ivan-marchand/openflaps/mechanical/images/catalog/02-front.jpg

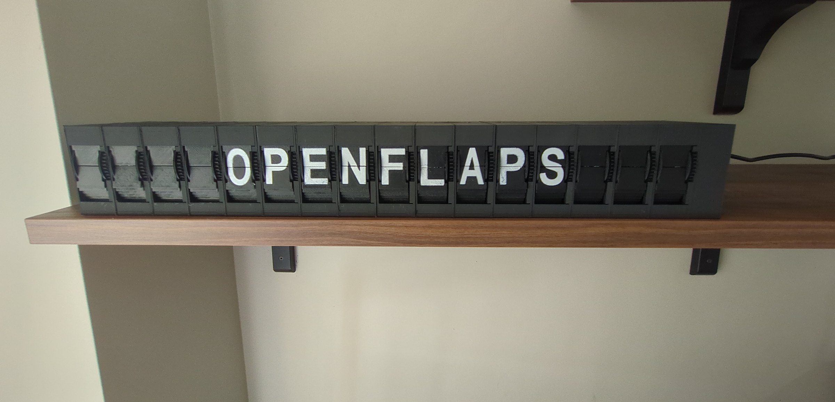
mechanical/images/catalog/02-front.jpg
