ivan-marchand/openflaps/mechanical/images/catalog/04-desk.jpg

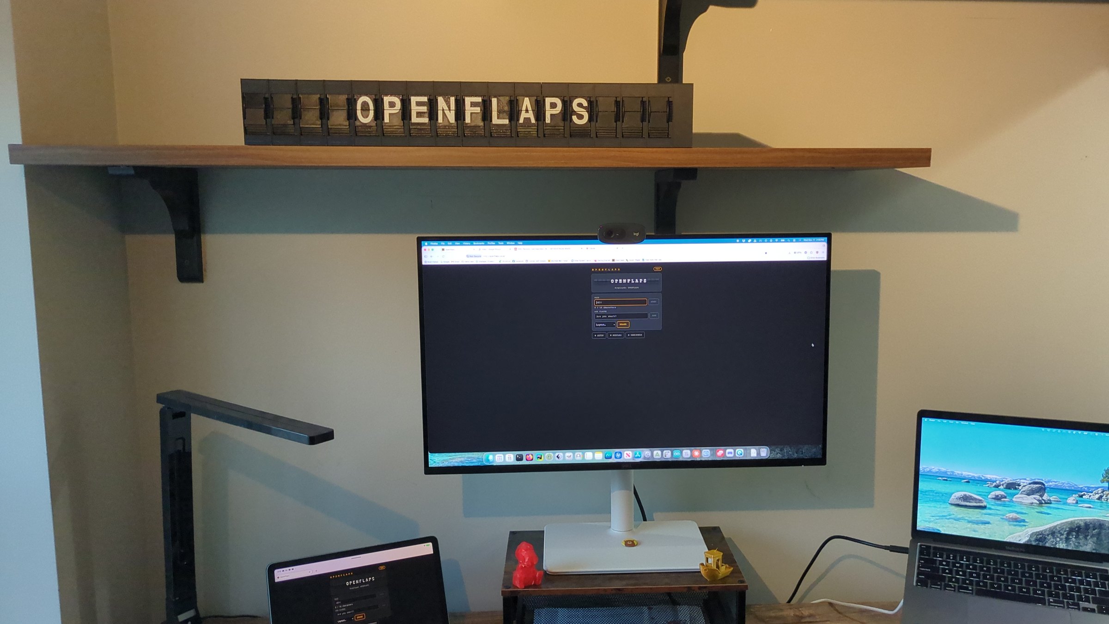
mechanical/images/catalog/04-desk.jpg
