ivan-marchand/openflaps/mechanical/images/catalog/08-layout-fields.jpg

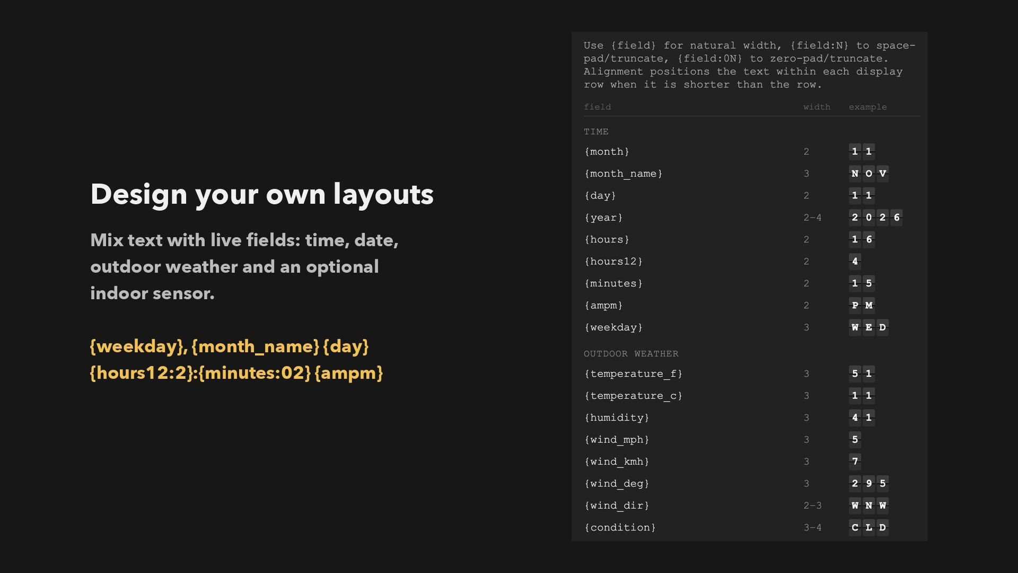
mechanical/images/catalog/08-layout-fields.jpg
