ivan-marchand/openflaps/mechanical/images/photos/03c-left-wheel-back-with-holder.jpg

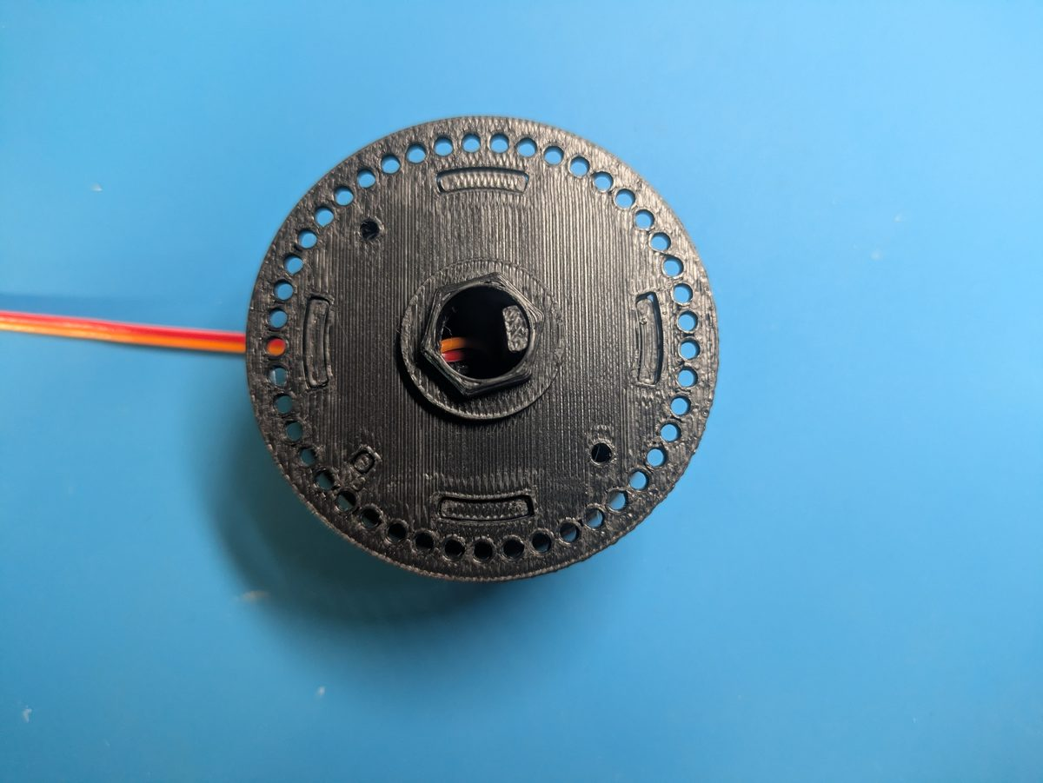
mechanical/images/photos/03c-left-wheel-back-with-holder.jpg
