ivan-marchand/openflaps/mechanical/images/photos/03d-wheels-joined-side-view.jpg

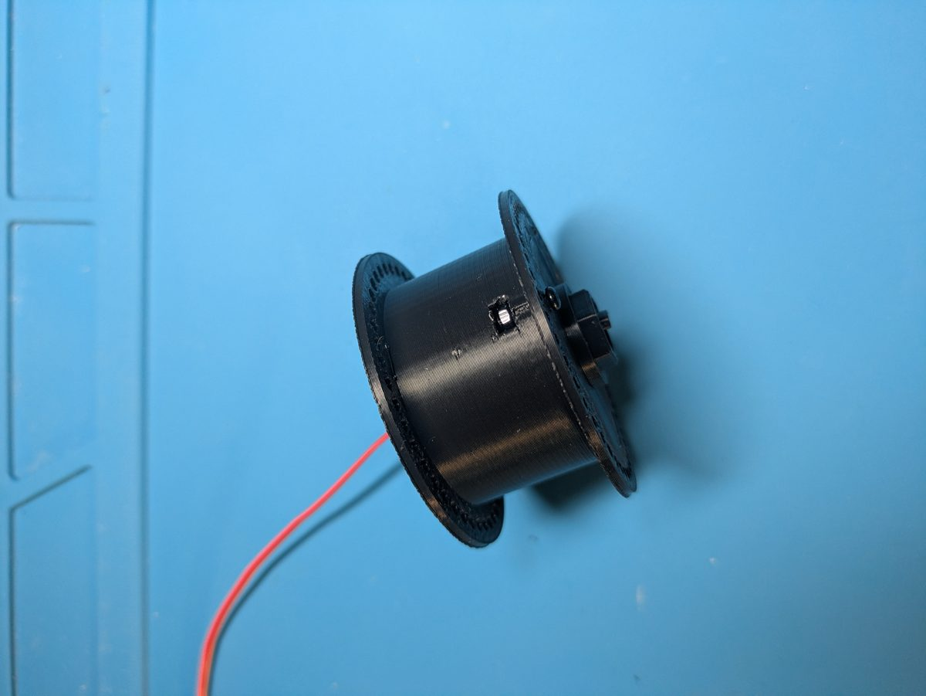
mechanical/images/photos/03d-wheels-joined-side-view.jpg
