ivan-marchand/openflaps/mechanical/images/photos/04b-first-flap-at-peg.jpg

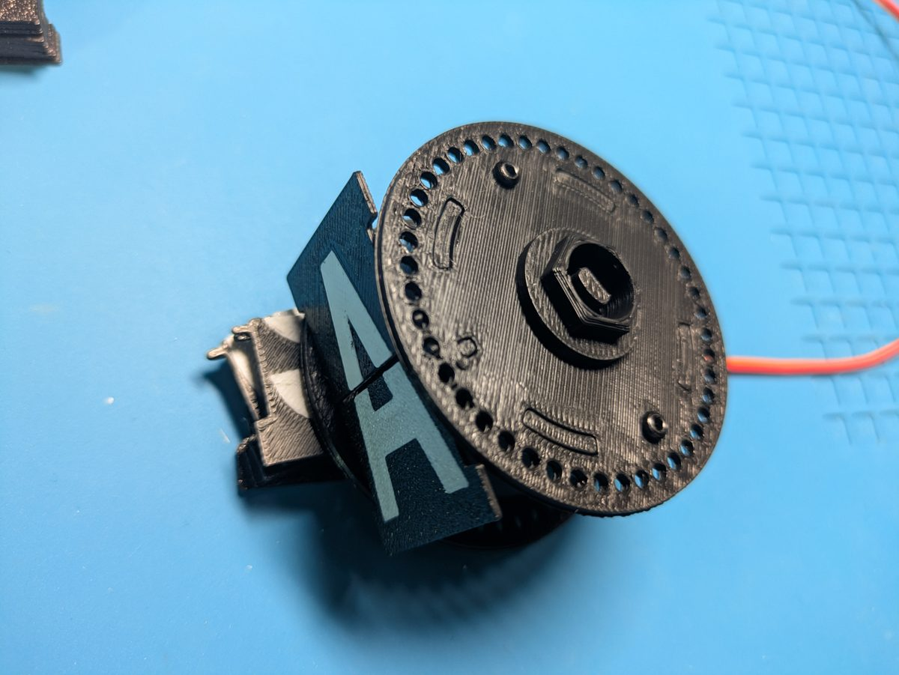
mechanical/images/photos/04b-first-flap-at-peg.jpg
