ivan-marchand/openflaps/mechanical/images/photos/04e-flaps-fully-loaded-back.jpg

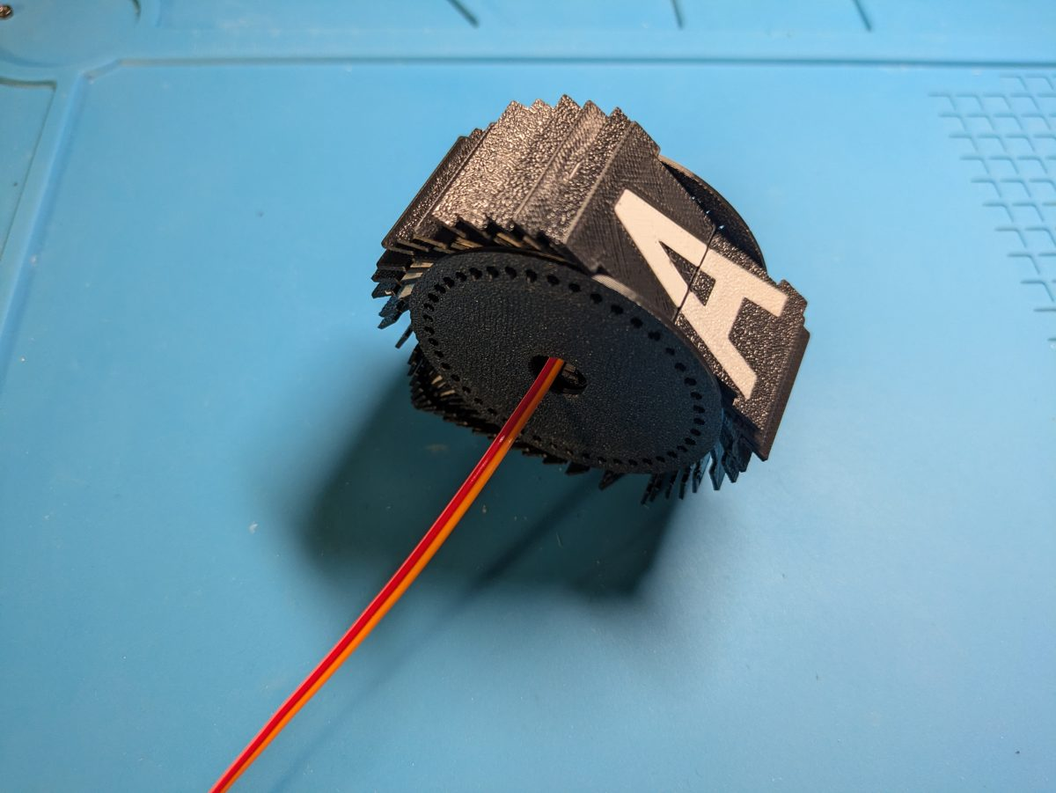
mechanical/images/photos/04e-flaps-fully-loaded-back.jpg
