ivan-marchand/openflaps/mechanical/images/photos/05c-wheel-mounted-in-frame.jpg

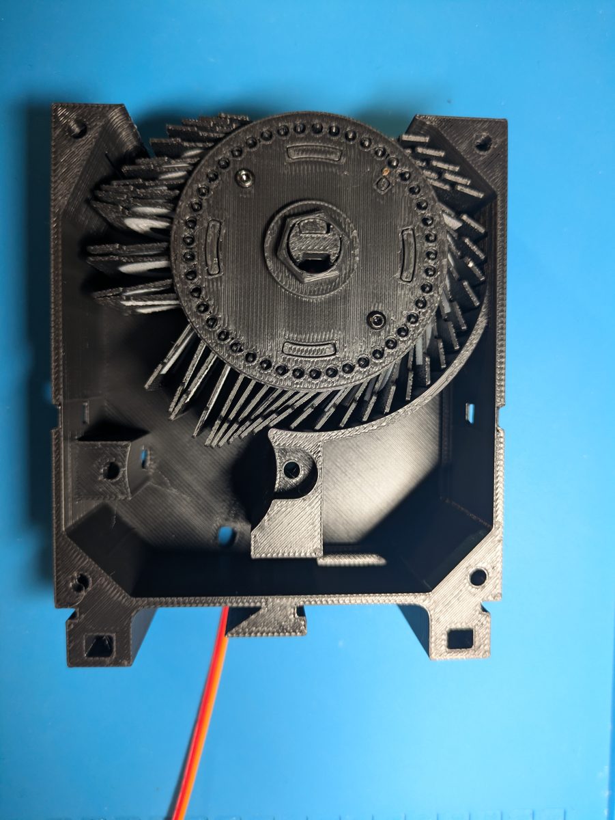
mechanical/images/photos/05c-wheel-mounted-in-frame.jpg
