ivan-marchand/openflaps/mechanical/images/photos/09b-lid-back-with-screws.jpg

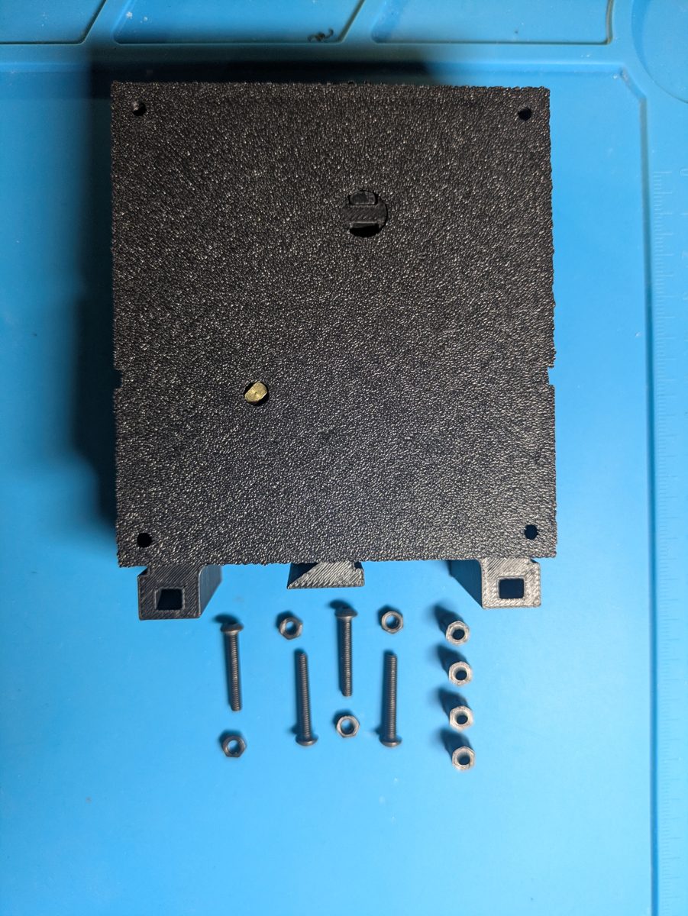
mechanical/images/photos/09b-lid-back-with-screws.jpg
