ivan-marchand/openflaps/mechanical/images/photos/09d-closed-case-angled-with-pegs.jpg

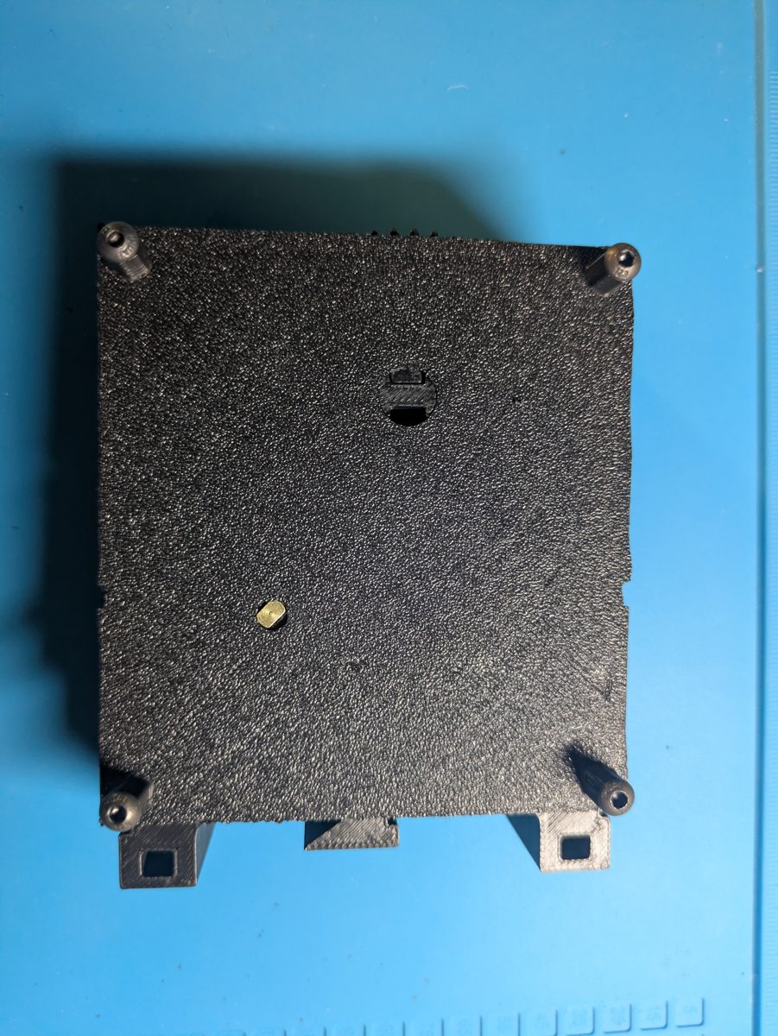
mechanical/images/photos/09d-closed-case-angled-with-pegs.jpg
