ivan-marchand/openflaps/mechanical/images/photos/09f-closed-case-back-wire-exit.jpg

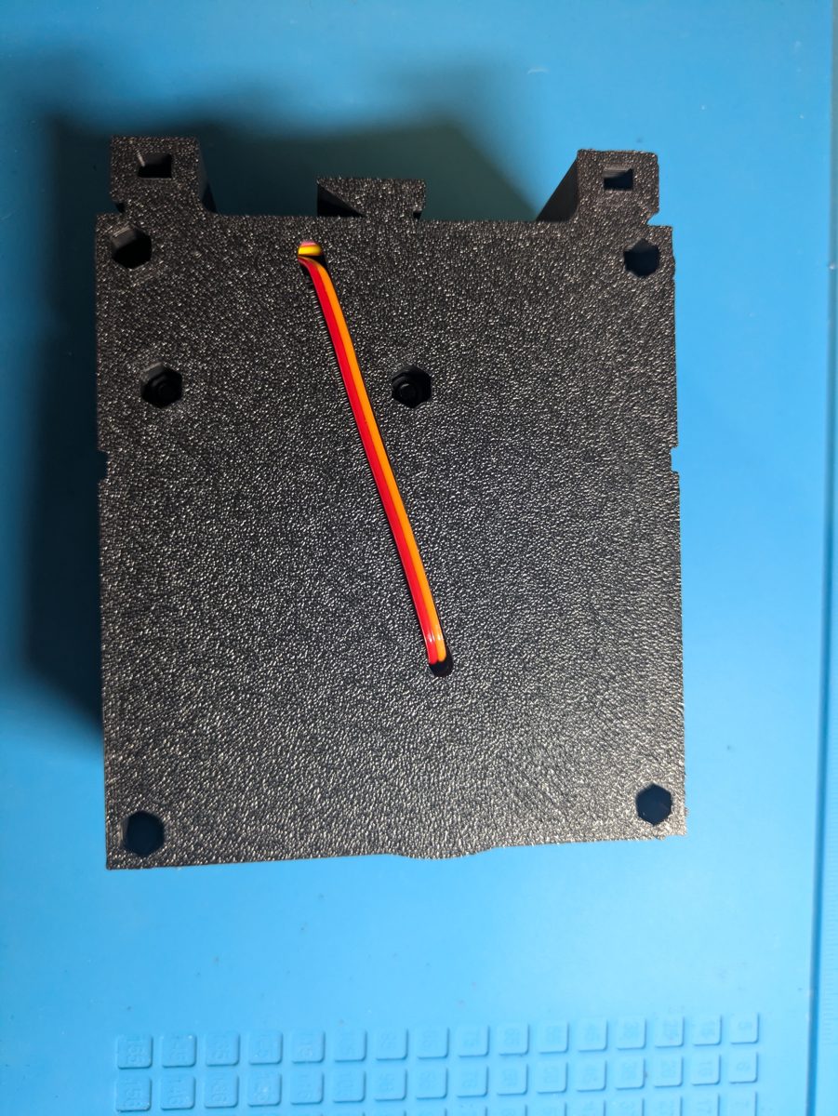
mechanical/images/photos/09f-closed-case-back-wire-exit.jpg
