ivan-marchand/openflaps/mechanical/images/photos/11d-pico-pcb-in-case-top.jpg

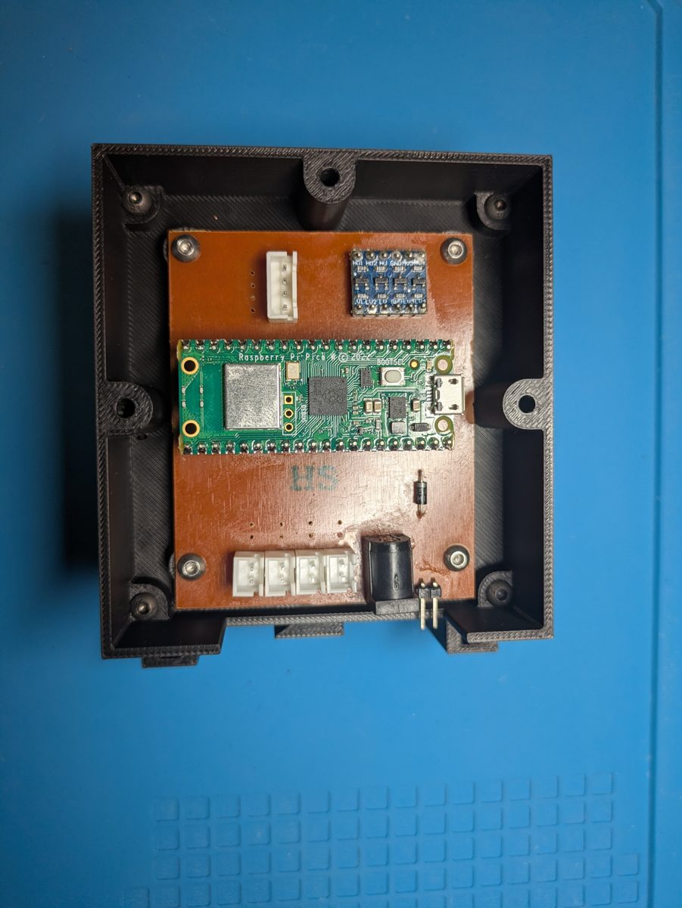
mechanical/images/photos/11d-pico-pcb-in-case-top.jpg
