ivan-marchand/openflaps/hardware/pcb/controller/BOM_PCB_Controller.csv

No. | Quantity | Comment | Designator | Footprint | Value | Manufacturer Part | Manufacturer | Supplier Part | Supplier
1 | 1 | ATTINY84A-SSF | ATTINY84 | SOIC-14_L8.7-W3.9-P1.27-LS6.0-BL |  | ATTINY84A-SSF | MICROCHIP(美国微芯) | C1340034 | LCSC
2 | 1 | 220uF | C1 | CAP-SMD_BD6.3-L6.6-W6.6-FD | 220uF | RST220UF10V018 | KNSCHA(科尼盛) | C4747973 | LCSC
3 | 1 | 100nF | C2 | CAP-SMD_L3.2-W1.6-RD | 100nF | CA45-A-35V-0.1UF-K | CEC(振华新云) | C2976900 | LCSC
4 | 1 | PZ2.54-1*2 | HOME | HDR-TH_2P-P2.54-V-M-3 |  | PZ2.54-1*2 | ZHOURI(洲日) | C5360898 | LCSC
5 | 1 | 2.54-2*3 | ICSP | HDR-TH_6P-P2.54-V-R2-C3-S2.54_A2541WV-2X3P |  | 2.54-2*3 | ZHOURI(洲日) | C5116479 | LCSC
6 | 1 | HX PZ2.54-2x2P WC-A | INPUT | HDR-TH_4P-P2.54-H-M-R2-C2-S2.54-W10.0 |  | HX PZ2.54-2x2P WC-A | hanxia(韩下) | C41417350 | LCSC
7 | 1 | 10kΩ | R1 | R0603 | 10kΩ | RC0603FR-0710KL | YAGEO(国巨) | C98220 | LCSC
8 | 1 | XH2.54-5P | STEPPER | CONN-TH_5P-P2.54_C9900008095 |  | XH2.54-5P |  | C9900017328 | LCSC
9 | 1 | GT-TCB73B-H048-L1 | SW | SW-TH_G-SWITCH_GT-TCB73B-H048-L1 |  | GT-TCB73B-H048-L1 | G-Switch(品赞) | C2890354 | LCSC
10 | 1 | ULN2003 | ULN2003 | SOP-16_L9.9-W3.9-P1.27-LS6.0-BL |  | ULN2003 | MSKSEMI(美森科) | C5252903 | LCSC
