ivan-marchand/openflaps/hardware/pcb/daisy-chain/BOM_PCB_Daisy_Chain.csv

No. | Quantity | Comment | Designator | Footprint | Value | Manufacturer Part | Manufacturer | Supplier Part | Supplier
1 | 1 | JXT-XH2.54-2PWZ | 5V | CONN-TH_2P-P2.54_JXT-XH2.54-2PWZ |  | JXT-XH2.54-2PWZ | JXTCONN(聚兴泰) | C53207536 | LCSC
2 | 4 | HX PM2.54-2x2P ZC | D1,D2,D3,D4 | CONN-TH_HX-PM2.54-2X2P-ZC |  | HX PM2.54-2x2P ZC | hanxia(韩下) | C32713303 | LCSC
3 | 1 | HX PM2.54-1x2P WC-Y | I2CIN | HDR-TH_2P-P2.54-H-F-W10.2-N |  | HX PM2.54-1x2P WC-Y | hanxia(韩下) | C22438143 | LCSC
4 | 1 | PZ254-1-02-W-8.5 | U1 | HDR-TH_2P-P2.54-H-M-W10.4 |  | PZ254-1-02-W-8.5 | HCTL(华灿天禄) | C3012223 | LCSC
