ivan-marchand/openflaps/hardware/pcb/pico-controller/BOM_PCB_Pico_Controller.csv

No. | Quantity | Comment | Designator | Footprint | Value | Manufacturer Part | Manufacturer | Supplier Part | Supplier
1 | 1 | DC-005-A25 | 5V-IN | DC-IN-TH_DC-005-A20 |  | DC-005-A25 | Yuandi(元迪) | C19077753 | LCSC
2 | 8 | A2502-WV02 | 5V-OUT1,5V-OUT2,5V-OUT3,5V-OUT4,5V-OUT5,5V-OUT6,5V-OUT7,5V-OUT8 | CONN-TH_A2502-WV02 |  | A2502-WV02 |  | C9900002556 | LCSC
3 | 2 | SH-XH2.54-4PZZ | ACCI2C1,ACCI2C2 | CONN-TH_4P-P2.50_BX-XH2.54-4PZZ |  | SH-XH2.54-4PZZ | SHOU HAN(首韩) | C54431935 | LCSC
4 | 1 | 1N5819 | D1 | DO-41_BD2.4-L4.7-P8.70-D0.8-RD |  | 1N5819 | luJing(鲁晶) | C49318088 | LCSC
5 | 1 | PZ254-1-02-W-8.5 | I2C | HDR-TH_2P-P2.54-H-M-W10.4 |  | PZ254-1-02-W-8.5 | HCTL(华灿天禄) | C3012223 | LCSC
6 | 1 | IIC I2C Logic Level Converter | I2CConverter | DPI-12 10.5W
7 | 2 | 254PM-1x20P-V | PICO1,PICO2 | HDR-TH_20P-P2.54-V-F-2 |  | 254PM-1x20P-V | LXWCONN(连兴旺电子) | C53202183 | LCSC
