ivan-marchand/openflaps/mechanical/images/photos/04a-flap-parts.jpg

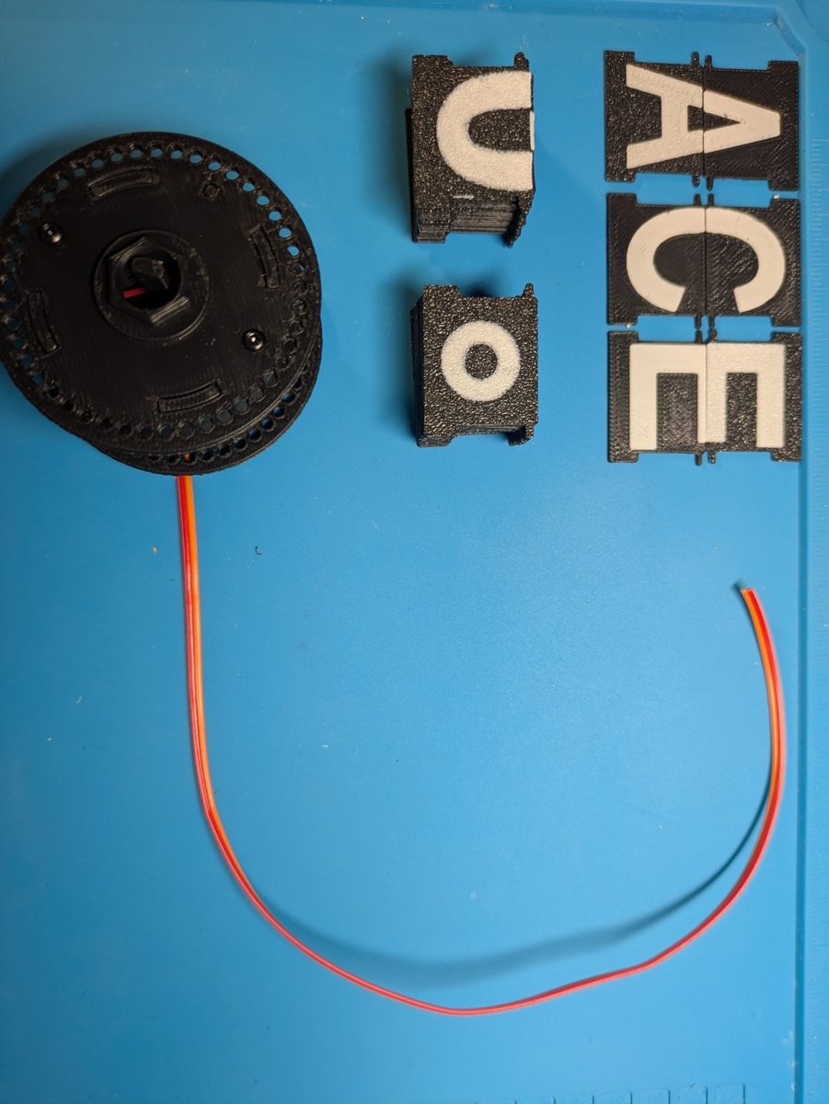
mechanical/images/photos/04a-flap-parts.jpg
