ivan-marchand/openflaps/mechanical/images/photos/05a-frame-and-wheel-parts.jpg

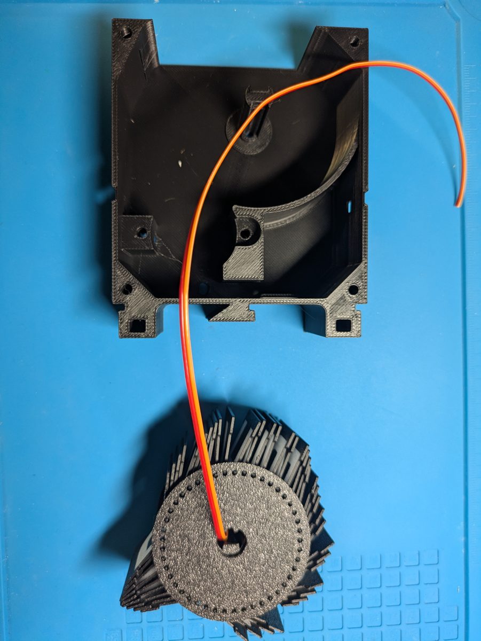
mechanical/images/photos/05a-frame-and-wheel-parts.jpg
