ivan-marchand/openflaps/mechanical/images/photos/07a-gear-parts.jpg

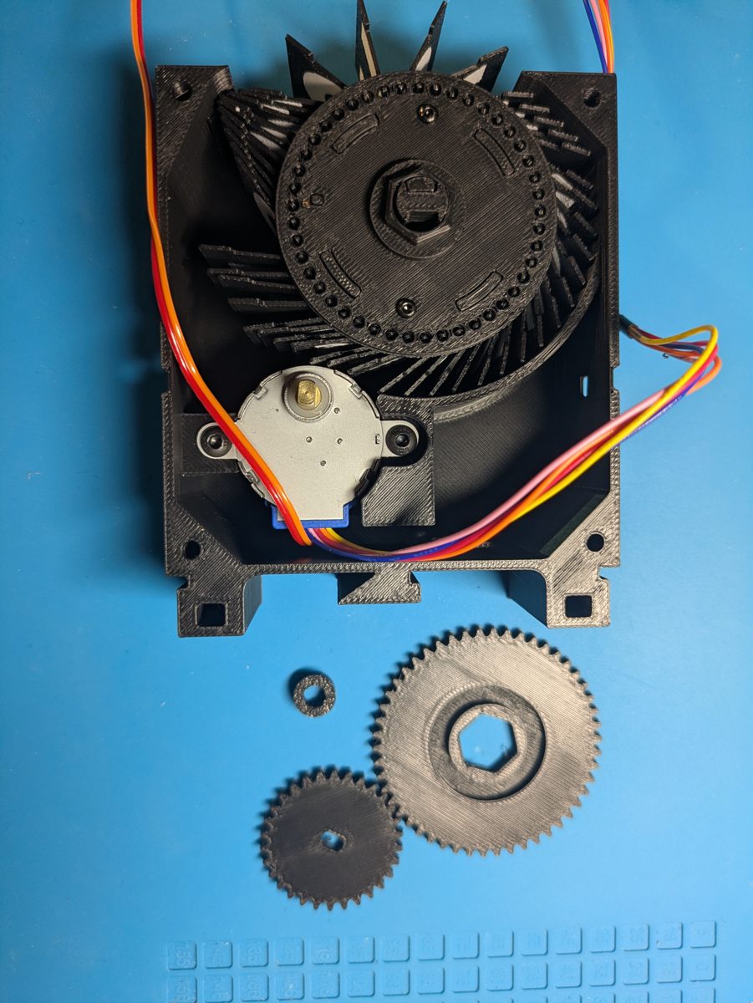
mechanical/images/photos/07a-gear-parts.jpg
