ivan-marchand/openflaps/mechanical/images/photos/08a-pcb-header-parts.jpg

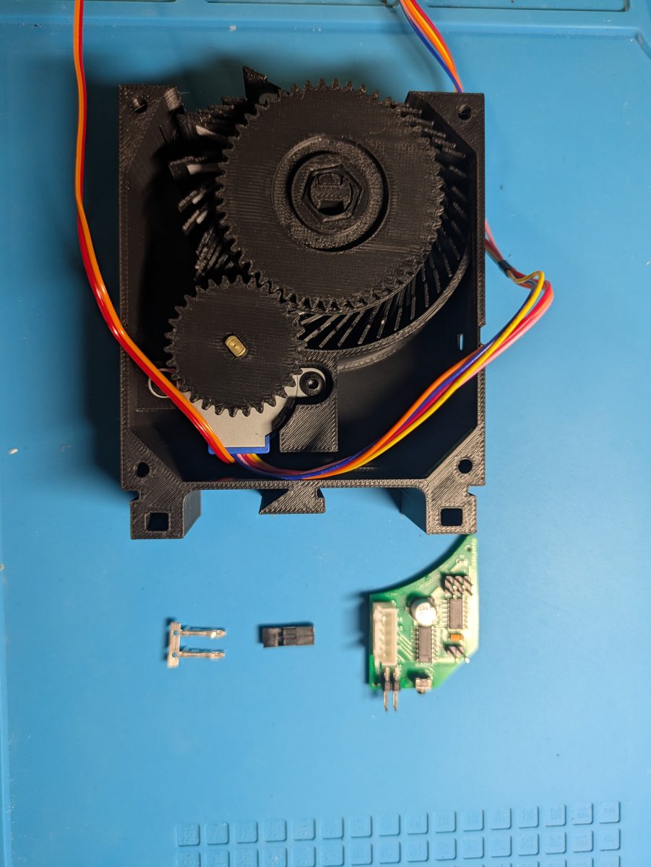
mechanical/images/photos/08a-pcb-header-parts.jpg
