ivan-marchand/openflaps/mechanical/images/photos/08b-pcb-header-parts-angle2.jpg

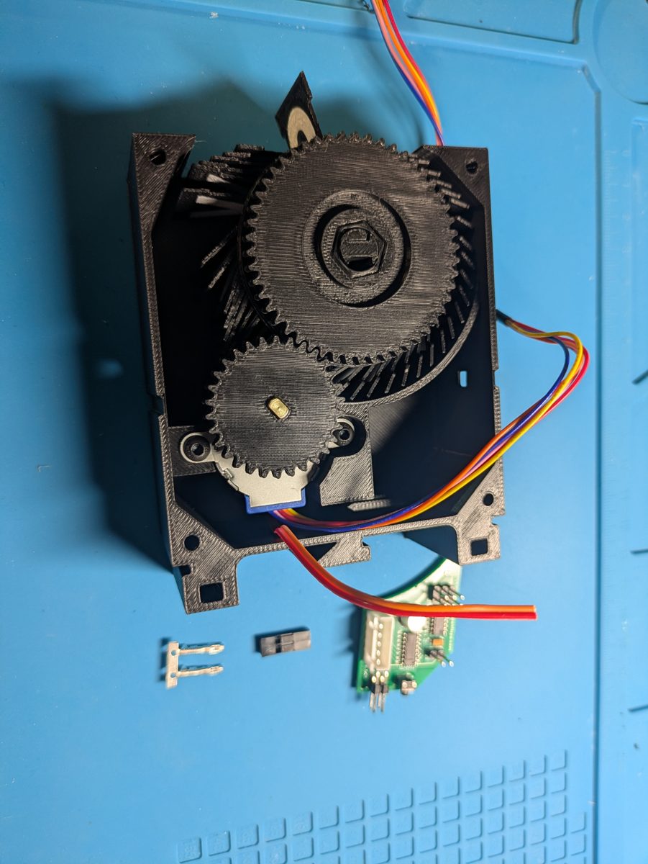
mechanical/images/photos/08b-pcb-header-parts-angle2.jpg
