ivan-marchand/openflaps/mechanical/stl/flaps/flap_13_5_6.3mf

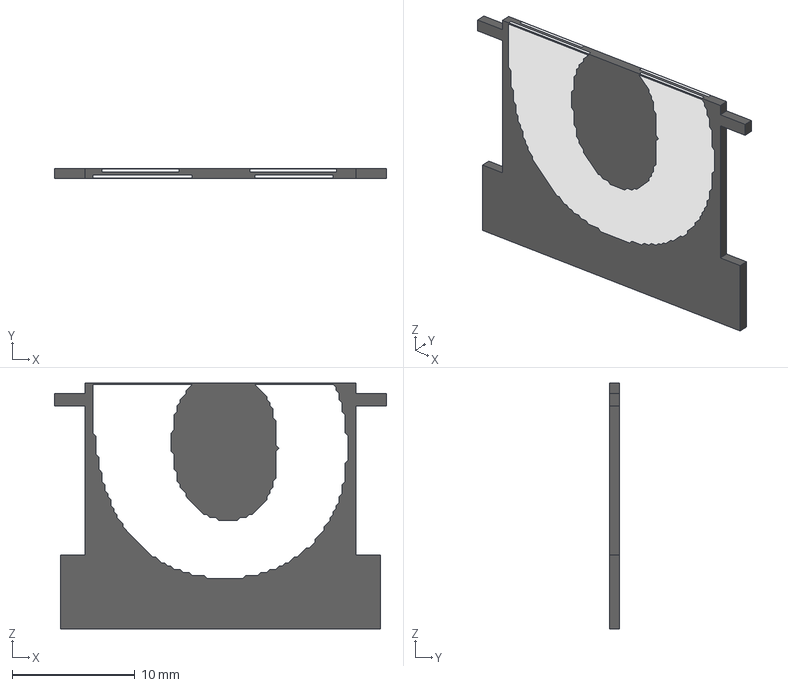
[picture p24: CAD file, 2026-11-07]
mechanical/stl/flaps/flap_13_5_6.3mf
27.0 x 0.802 x 20.0 mm
flap
5_top_front
6_bottom_back
