ivan-marchand/openflaps/mechanical/stl/Split Flap Character - Front Connector Peg.stl

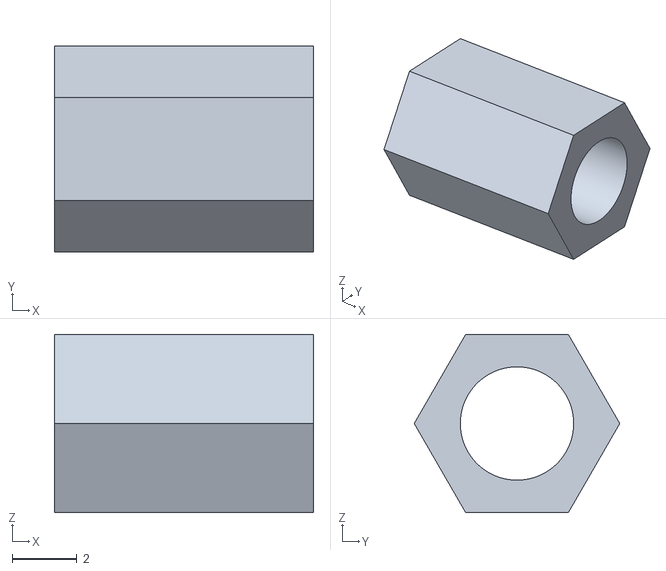
[picture p25: CAD file, 2026-11-07]
mechanical/stl/Split Flap Character - Front Connector Peg.stl
8.00 x 6.35 x 5.50
