ivan-marchand/openflaps/mechanical/stl/flaps/flap_34_K_L.3mf

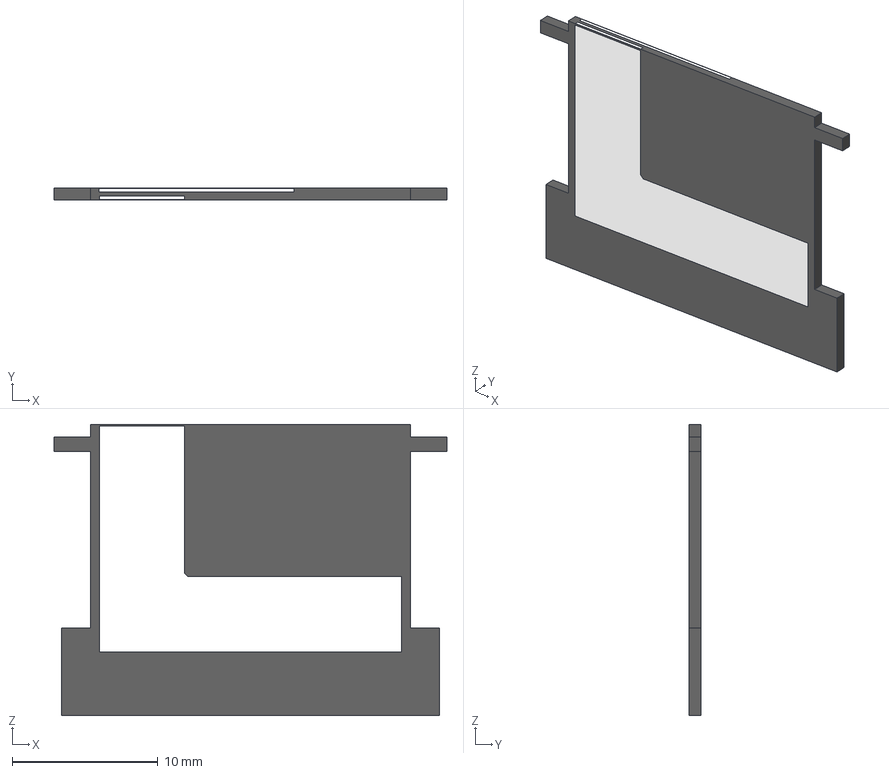
[picture p26: CAD file, 2026-11-07]
mechanical/stl/flaps/flap_34_K_L.3mf
27.0 x 0.802 x 20.0 mm
flap
K_top_front
L_bottom_back
