ivan-marchand/openflaps/mechanical/stl/Split Flap Character - Pico Case Lid.stl

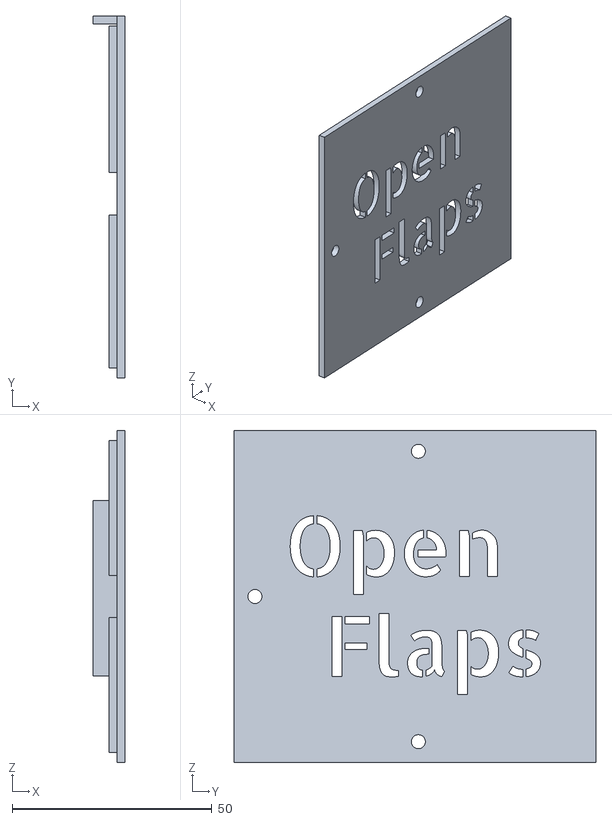
[picture p27: CAD file, 2026-11-07]
mechanical/stl/Split Flap Character - Pico Case Lid.stl
8.00 x 90.6 x 83.1
