ivan-marchand/openflaps/mechanical/stl/flaps/flap_18_0_1.3mf

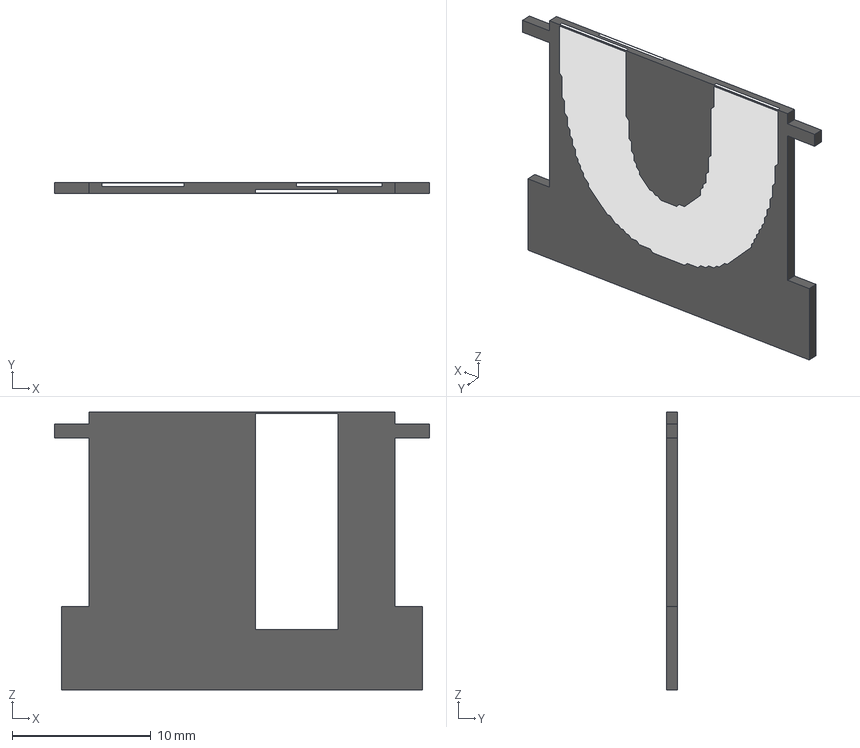
[picture p28: CAD file, 2026-11-07]
mechanical/stl/flaps/flap_18_0_1.3mf
27.0 x 0.802 x 20.0 mm
flap
0_top_front
1_bottom_back
