ivan-marchand/openflaps/mechanical/stl/Split Flap Character - Pico Case.stl

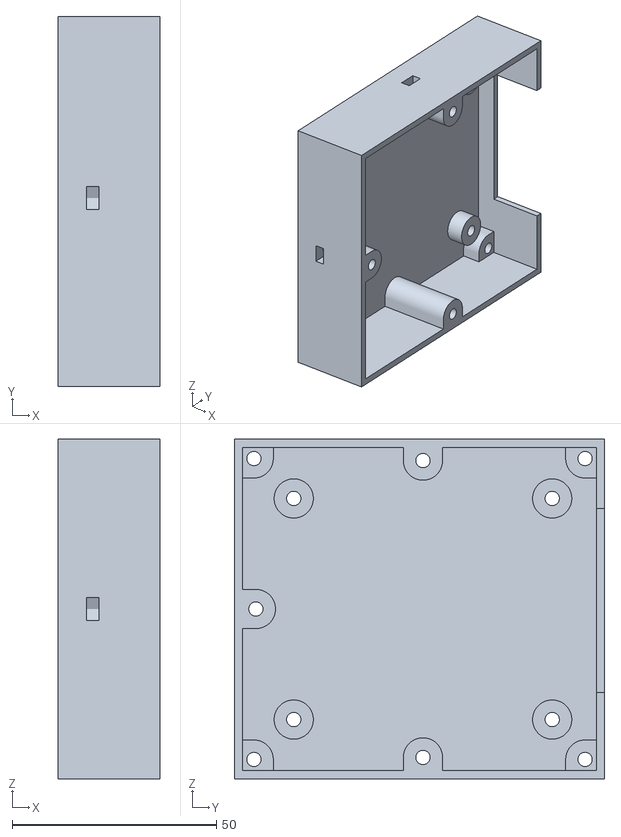
[picture p29: CAD file, 2026-11-07]
mechanical/stl/Split Flap Character - Pico Case.stl
25.0 x 90.6 x 83.1
