ivan-marchand/openflaps/mechanical/stl/flaps/flap_35_J_K.3mf

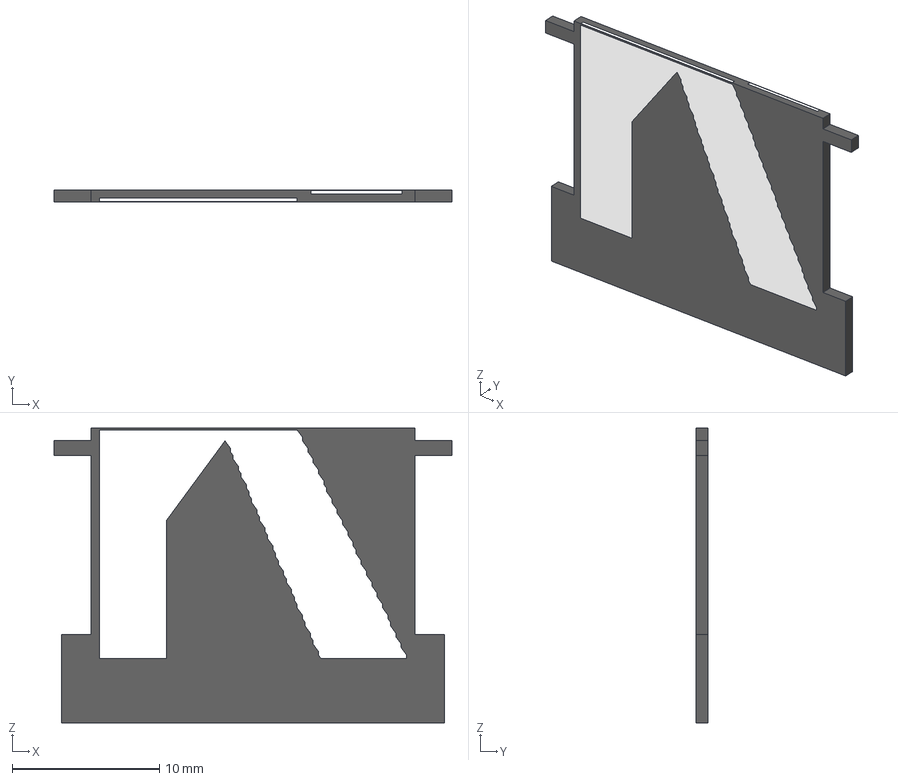
[picture p30: CAD file, 2026-11-07]
mechanical/stl/flaps/flap_35_J_K.3mf
27.0 x 0.802 x 20.0 mm
flap
J_top_front
K_bottom_back
