ivan-marchand/openflaps/mechanical/stl/Split Flap Character - Character Attachment Clip.stl

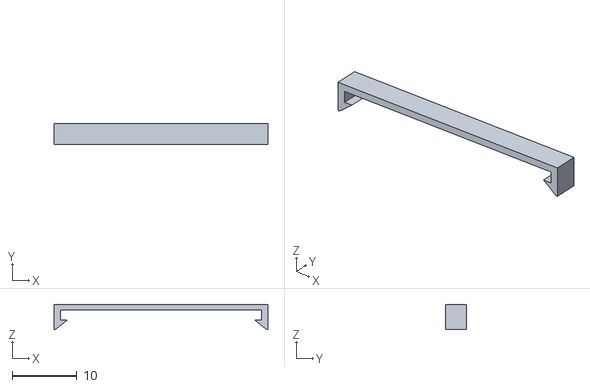
[picture p31: CAD file, 2026-11-07]
mechanical/stl/Split Flap Character - Character Attachment Clip.stl
33.1 x 3.20 x 3.90
