ivan-marchand/openflaps/mechanical/stl/Split Flap Character - Frame.stl

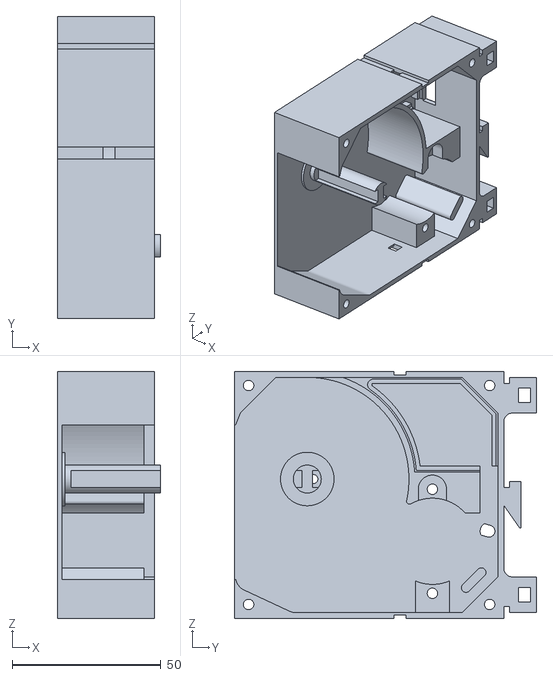
[picture p32: CAD file, 2026-11-07]
mechanical/stl/Split Flap Character - Frame.stl
34.5 x 101.6 x 83.1
