ivan-marchand/openflaps/mechanical/stl/Split Flap Character - Lid.stl

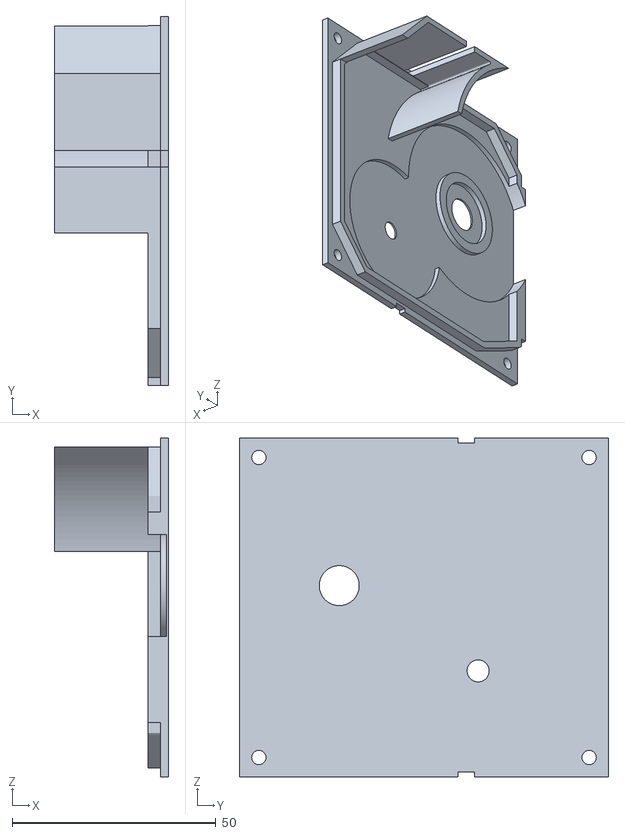
[picture p33: CAD file, 2026-11-07]
mechanical/stl/Split Flap Character - Lid.stl
28.0 x 90.6 x 83.1
