ivan-marchand/openflaps/mechanical/stl/Split Flap Character - Stepper Motor Gear Spacer.stl

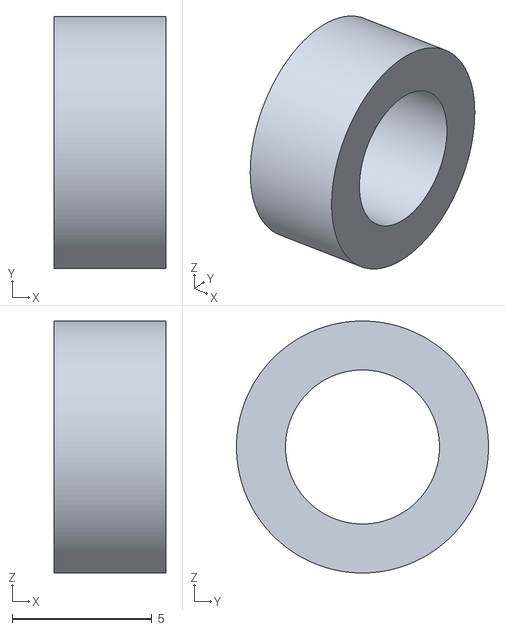
[picture p34: CAD file, 2026-03-02]
mechanical/stl/Split Flap Character - Stepper Motor Gear Spacer.stl
4.00 x 9.00 x 9.00
