ivan-marchand/openflaps/mechanical/stl/Gear 50x30 - Wheel 50.stl

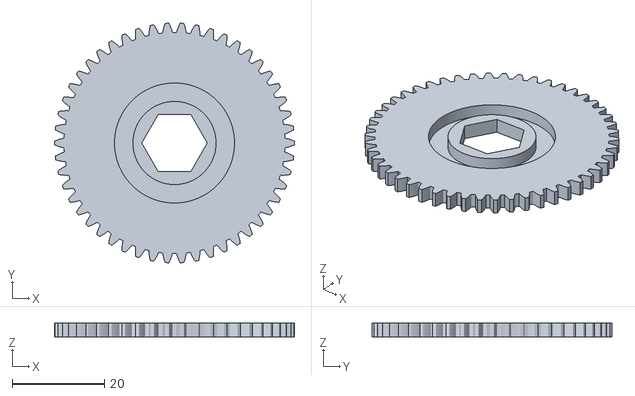
[picture p35: CAD file, 2026-03-02]
mechanical/stl/Gear 50x30 - Wheel 50.stl
52.0 x 51.9 x 3.00
