ivan-marchand/openflaps/mechanical/stl/Split Flap Character - Left Wheel.stl

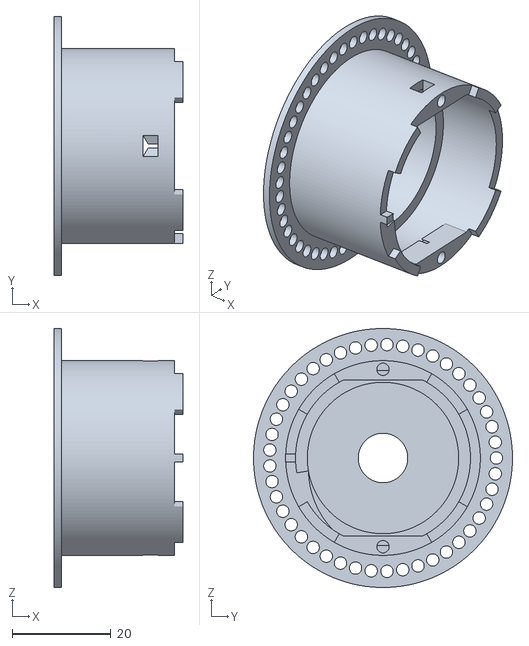
[picture p36: CAD file, 2026-03-02]
mechanical/stl/Split Flap Character - Left Wheel.stl
26.0 x 52.4 x 52.4
