ivan-marchand/openflaps/mechanical/stl/Split Flap Character - Flap.stl

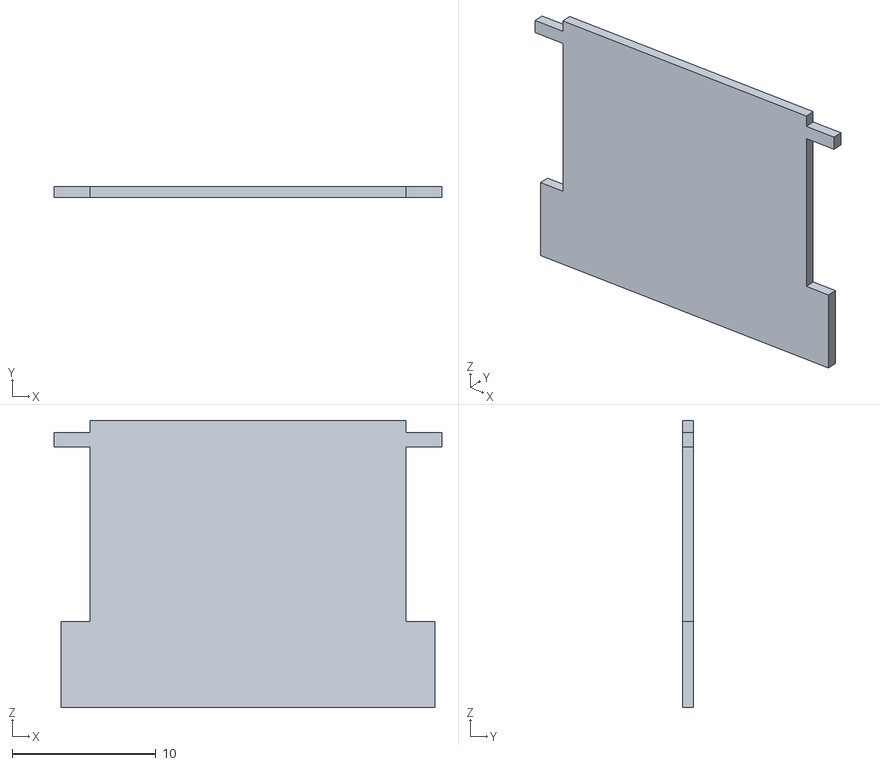
[picture p37: CAD file, 2026-03-02]
mechanical/stl/Split Flap Character - Flap.stl
27.0 x 0.8 x 20.0
