ivan-marchand/openflaps/mechanical/stl/Split Flap Character - Limit Switch Support.stl

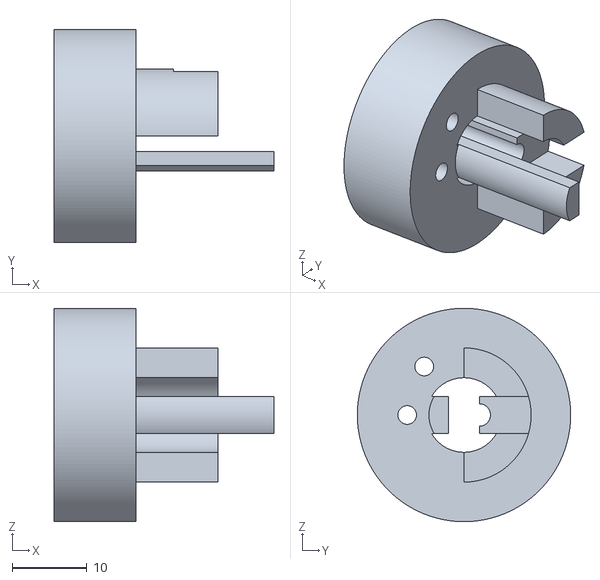
[picture p38: CAD file, 2026-03-02]
mechanical/stl/Split Flap Character - Limit Switch Support.stl
29.5 x 28.6 x 28.6
