ivan-marchand/openflaps/mechanical/stl/flaps/flap_32_M_N.3mf

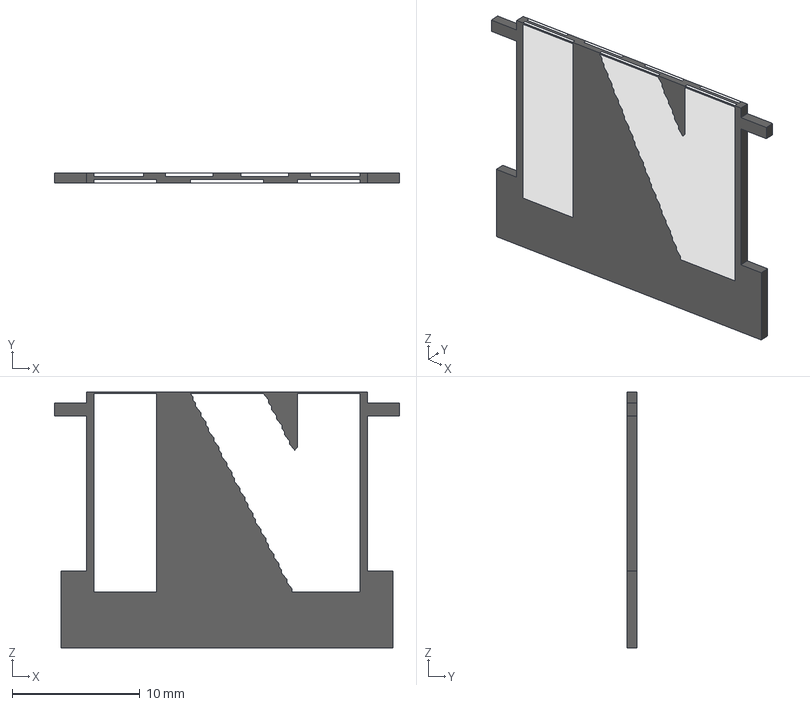
[picture p39: CAD file, 2026-11-07]
mechanical/stl/flaps/flap_32_M_N.3mf
27.0 x 0.802 x 20.0 mm
flap
M_top_front
N_bottom_back
