ivan-marchand/openflaps/mechanical/stl/Gear 50x30 - Stepper 30.stl

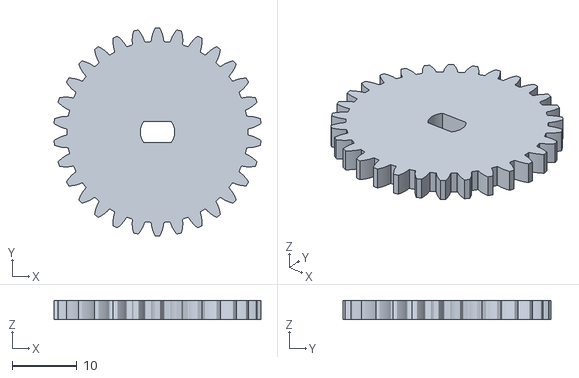
[picture p40: CAD file, 2026-03-02]
mechanical/stl/Gear 50x30 - Stepper 30.stl
31.9 x 32.0 x 3.00
