ivan-marchand/openflaps/mechanical/stl/flaps/flap_4_!_.3mf

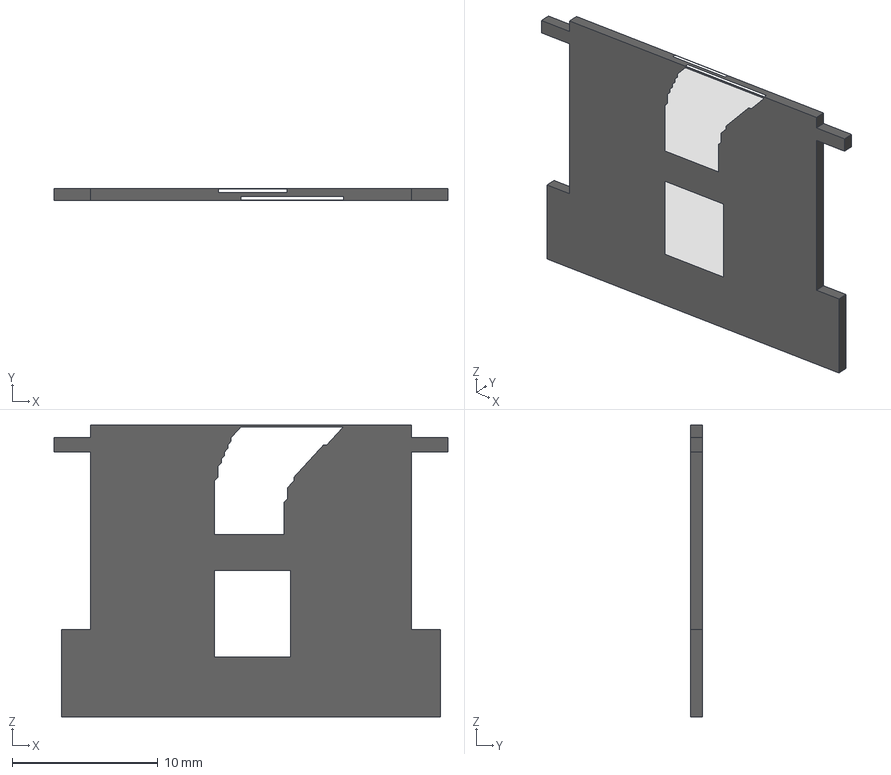
[picture p41: CAD file, 2026-11-07]
mechanical/stl/flaps/flap_4_!_.3mf
27.0 x 0.802 x 20.0 mm
flap
!_top_front
?_bottom_back
