ivan-marchand/openflaps/mechanical/stl/Split Flap Character - Right Wheel.stl

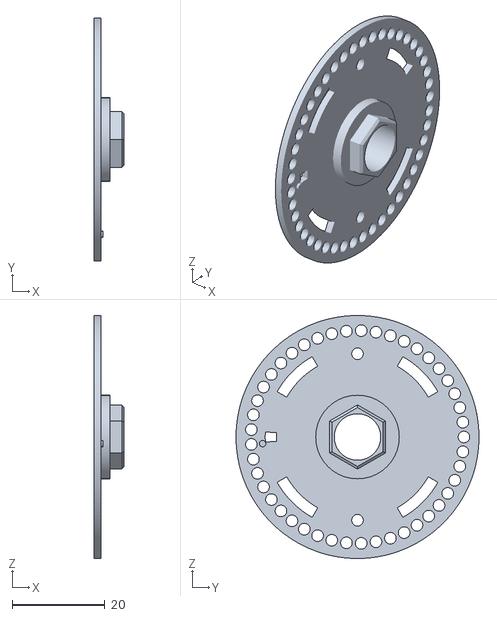
[picture p42: CAD file, 2026-03-02]
mechanical/stl/Split Flap Character - Right Wheel.stl
6.50 x 52.4 x 52.4
