ivan-marchand/openflaps/mechanical/stl/flaps/flap_2__°.3mf

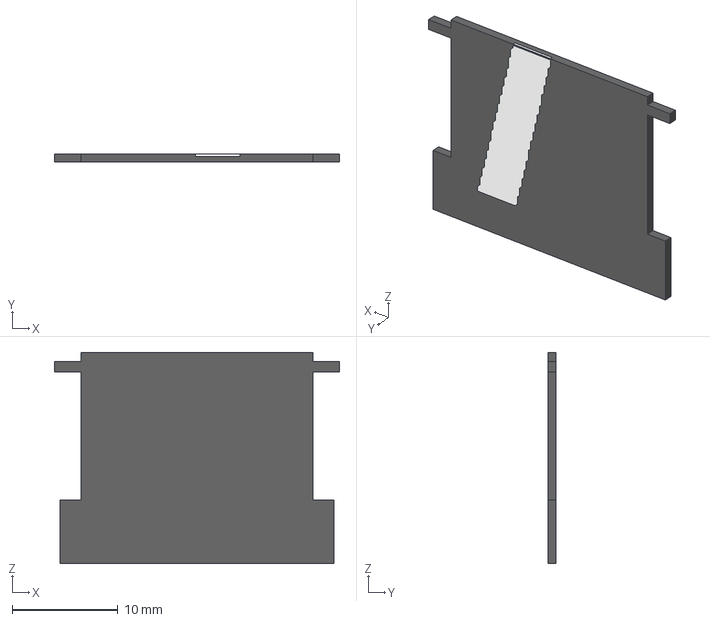
[picture p44: CAD file, 2026-11-07]
mechanical/stl/flaps/flap_2__°.3mf
27.0 x 0.801 x 20.0 mm
flap
/_top_front
