ivan-marchand/openflaps/mechanical/stl/flaps/flap_7_,_.3mf

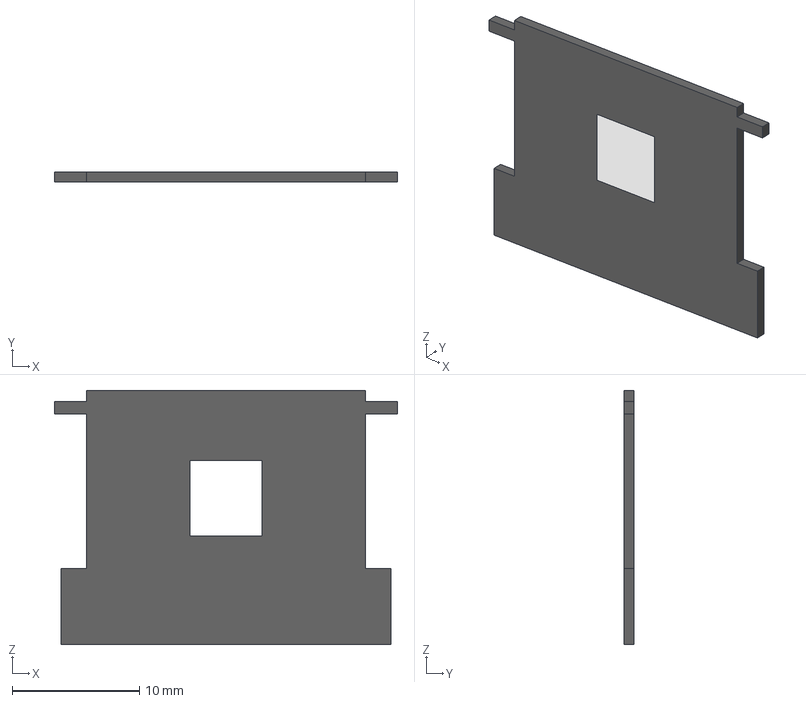
[picture p45: CAD file, 2026-11-07]
mechanical/stl/flaps/flap_7_,_.3mf
27.0 x 0.801 x 20.0 mm
flap
:_bottom_back
