ivan-marchand/openflaps/(list of files, cad)

Other CAD files:
mechanical/stl/flaps/flap_17_1_2.3mf
mechanical/stl/flaps/flap_30_O_P.3mf
mechanical/stl/flaps/flap_19_Z_0.3mf
mechanical/stl/flaps/flap_20_Y_Z.3mf
mechanical/stl/flaps/flap_22_W_X.3mf
mechanical/stl/flaps/flap_25_T_U.3mf
mechanical/stl/flaps/flap_36_I_J.3mf
mechanical/stl/flaps/flap_42_C_D.3mf
mechanical/stl/flaps/flap_45__A.3mf
mechanical/stl/flaps/flap_10_8_9.3mf
mechanical/stl/flaps/flap_15_3_4.3mf
mechanical/stl/flaps/flap_39_F_G.3mf
mechanical/stl/flaps/flap_44_A_B.3mf
mechanical/stl/flaps/flap_43_B_C.3mf
mechanical/stl/flaps/flap_27_R_S.3mf
mechanical/stl/flaps/flap_8_._,.3mf
mechanical/stl/flaps/flap_26_S_T.3mf
mechanical/stl/flaps/flap_24_U_V.3mf
mechanical/stl/flaps/flap_40_E_F.3mf
mechanical/stl/flaps/flap_9_9_..3mf
mechanical/stl/flaps/flap_14_4_5.3mf
mechanical/stl/flaps/flap_41_D_E.3mf
mechanical/stl/flaps/flap_33_L_M.3mf
mechanical/stl/flaps/flap_28_Q_R.3mf
mechanical/stl/flaps/flap_16_2_3.3mf
mechanical/stl/flaps/flap_11_7_8.3mf
mechanical/stl/flaps/flap_12_6_7.3mf
mechanical/stl/flaps/flap_37_H_I.3mf
mechanical/stl/flaps/flap_5_-_!.3mf
mechanical/stl/flaps/flap_21_X_Y.3mf
mechanical/stl/flaps/flap_38_G_H.3mf
mechanical/stl/flaps/flap_23_V_W.3mf
mechanical/stl/flaps/flap_6__-.3mf
mechanical/stl/flaps/flap_31_N_O.3mf
mechanical/stl/flaps/flap_29_P_Q.3mf
