ivan-marchand/openflaps/(commit log)

2026-03-02 Secure WiFi credentials and improve Pico web UI
    - Remove hardcoded WiFi SSID/password from source code
    - Store credentials in wifi_config.json on flash (persistent, like EEPROM)
    - Add AP provisioning mode (OpenFlap-Setup hotspot) for first-time setup
    - Add /wifi route to update credentials from the web UI
    - Extract HTML into index.html and setup.html on the filesystem
    - Add render_template() to serve HTML files with {{placeholder}} substitution
    - Switch web UI from GET + <a> tags to POST forms so the URL stays at /
    - Add .gitignore (covers .idea/, __pycache__, wifi_config.json, .DS_Store)
2026-03-02 Fix AP provisioning mode reliability
    - Explicitly set AP ifconfig to ensure 192.168.4.1 is always used
    - Bind provisioning server to 192.168.4.1 instead of 0.0.0.0
    - Set ap.config() before ap.active(True) (required on Pico W)
    - Disable STA interface before starting AP to avoid mode conflicts
    - On failed STA connection: delete config + hard reset instead of
    switching modes mid-run (CYW43 chip doesn't reliably switch STA->AP)
    - Silence expected accept() ETIMEDOUT errors in provisioning loop
    [main.py]
2026-03-02 Improve web UI and temperature display
    - Hide WiFi Settings behind a toggle button in index.html
    - Display temperature immediately when switching to temp mode
    - Update temperature every 60s using elapsed time instead of modulo
2026-03-04 Add Claude API integration for 4-char display responses
    - Add call_claude() making raw HTTPS POST to api.anthropic.com/v1/messages
    using ssl.wrap_socket() (no SDK available on MicroPython)
    - Use claude-haiku-4-5 model for fast, cheap responses
    - System prompt constrains output to exactly 4 chars using display charset:
    space A-Z 0-9 . , : - ! ? / degree-sign
    - Sanitize response to strip any characters not supported by the display
    - Encode payload to bytes before measuring Content-Length to handle
    multi-byte UTF-8 characters correctly
    - Store API key in api_config.json on flash (separate from wifi_config.json)
    - Add load_api_key() / save_api_key() for persistent key storage
    - Add Ask Cla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
    [main.py]
2026-03-05 Add button support, new I2C commands, and missed-step tracking to ATtiny84 firmware
    ATtiny84 firmware (renamed from _attinycore suffix):
    - Interrupt-driven button on INT0: short press advances character, long press (3s) resets I2C address to 0x10 for re-pairing
    - New I2C command 'A': display the character corresponding to this module's address (0x10-0x19 -> 0-9, 0x1A+ -> A-Z)
    - New I2C command 'P': master reads back speed, offset, and average missed steps via Wire.onRequest
    - Track missed steps per revolution (rolling average over last 10 homing events), exposed in 'P' response
    - Proper uint types throughout, snake_case naming, DBG_WAIT_FOR_SERIAL macro
    Pico firmware:
    - Add display_address(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
    [main.py, split_flap_display_async.ino]
2026-03-08 feat: remove config cards from main page, add Setup button
2026-03-08 fix: remove redundant params parsing in /setup route
    [main.py]
2026-03-08 fix: conn=None before reset, fix button-in-anchor in index.html
    [main.py]
2026-03-08 fix: remove debug print from print_char
    [main.py]
2026-03-08 Cleanup arduino code
2026-03-08 feat: add JSON API endpoints to Pico server
2026-03-08 feat: wire up App with hash routing and dark theme
2026-03-08 feat: add built Preact SPA to Pico firmware
2026-03-08 feat: add deploy.sh script for uploading firmware to Pico via mpremote
2026-03-08 fix: improve Pico detection in deploy.sh, use explicit port
2026-03-09 feat: sync display state to UI every 1s, track last_text in time/temp modes
2026-03-09 fix: add method guard, input validation to /api/modules routes
    [main.py]
2026-03-09 feat: show I2C address in hex on modules page
2026-03-09 fix: pop front in print_string so chars display left to right
    [main.py]
2026-03-09 fix: re-register Wire callbacks after address change to restore I2C
    [split_flap_display_async.ino]
2026-03-09 feat: add ID button to modules page to display address on each module
2026-03-09 fix: add 20ms delay between I2C writes so ATtiny can process each command
    [main.py]
2026-03-09 fix: skip O/S writes when unchanged to save EEPROM cycles
    [main.py]
2026-03-09 docs: add README landing page
2026-03-09 docs: add Pico W installation guide
2026-03-09 docs: add 3D print and assembly guide
2026-03-09 docs: fix ATtiny84 install guide (sketch path, USBasp pin, project name)
2026-03-10 build: update Pico assets with timezone selector
2026-03-10 fix: add tz.py to deploy script, explicit global, gitignore timezone config
    [main.py]
2026-03-10 fix: remove global declaration causing MicroPython boot crash
    [main.py]
2026-03-12 refactor: clean up main.py
    - Remove stale file-level comment block
    - Delete dead functions: update_offset, change_address, initialize_displays, display_address
    - Delete commented-out boot calls and noisy print in I2C polling loop
    - Fix /api/modules/identify: send 2 bytes (b'A\x00') as ATtiny protocol requires
    - Refactor parse_query to reuse parse_form, eliminating duplicated loop
    - Remove dead params parsing in handle_request (all routes use parse_json_body)
    - Convert url_decode and dechunk_http_body from += to list+join
    - Cache api_key at boot; save_api_key updates in-memory copy (eliminates flash read per Claude call)
    - Optimize tick(): single time.time() call, tz.get_offset() only compute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
    [main.py]
2026-03-12 refactor: make save_timezone update current_timezone global
    Consistent with save_api_key which updates api_key in-memory.
    Removes the redundant assignment in the endpoint handler.
2026-03-12 docs: explain inline imports in comments
    ssl and machine are deferred to avoid loading heavy modules at boot
    on the Pico W's constrained RAM (~200KB).
    [main.py]
2026-03-12 feat: retry NTP sooner on failure, extract timing constants
    - sync_time() now returns True/False
    - next_ntp_sync replaces last_ntp_sync: stores the absolute time of the
    next sync rather than the last, making the retry logic explicit
    - On NTP failure: retry after NTP_RETRY_INTERVAL (5 min)
    - On success: next sync after NTP_SYNC_INTERVAL (1 hour)
    - Extract NTP_SYNC_INTERVAL, NTP_RETRY_INTERVAL, TEMP_UPDATE_INTERVAL
    as named constants in the CONFIG section
    [main.py]
2026-03-12 fix: keep last temperature on fetch failure instead of showing ERR
    display_web_temp(current) now only shows ERR if there's no previous
    temperature to fall back on (e.g. first fetch after switching to
    temp mode). If a temperature is already displayed, a failed fetch
    returns None and the caller retains the last good value until the
    next TEMP_UPDATE_INTERVAL.
    [main.py]
2026-03-12 fix: use last_temp_update==0 to detect first temp fetch, not last_text
    last_text almost always has a clock value when entering MODE_TEMP,
    so passing it as the "has previous" signal never worked. last_temp_update
    is reset to 0 when switching to MODE_TEMP, making it the correct
    indicator of whether a temp has been fetched in this session.
    [main.py]
2026-03-12 fix: refresh clock display immediately when switching back to MODE_TIME
    Reset minutes=None on mode switch so the next tick unconditionally
    updates the display, instead of waiting up to a minute for the
    current minute to change.
    [main.py]
2026-03-12 fix: display current time immediately when switching to MODE_TIME
    Instead of using a sentinel to trigger the next tick, compute and
    display the current HHMM right away so the clock is visible
    instantly with no delay.
    [main.py]
2026-03-12 fix: correct project name OPENFLAP → OPENFLAPS in control page title
2026-03-12 feat: add npm copy script to sync built assets to firmware/pico
    npm run copy — copies dist/ assets to firmware/pico/
    npm run build — builds then copies automatically
2026-09-06 refactor: extract stepper + controller classes to split_flap_controller.h
    Byte-identical move of PowerManagedStepper and SplitFlapController plus
    read-only accessors for tests and the simulator. No behaviour change.
2026-09-06 test: characterize PowerManagedStepper timing and stepping
2026-09-06 test: characterize SplitFlapController homing state machine
2026-09-06 refactor: extract I2C command + button logic to attiny_protocol.h
    loop(), request_event() and the button #defines now route through
    handle_command / module_status / classify_button_press. Behaviour preserved.
2026-09-06 test: characterize handle_command / module_status / button classify
2026-09-06 feat(sim): module page — flap view, live inspector, drive loop
2026-09-06 feat(sim): I2C command console + hold-to-pair module button
2026-09-06 fix(sim): wrap-side limit switch, settling assertions, ISR revert, C++11 guard
    Review fix wave for the ATtiny84 simulator + host-test branch.
    FIX 1 (critical) — sim/main.cpp update_limit_switch reported the synthetic
    home switch HIGH at position 0. Homing terminates on the switch's RELEASE
    edge and defines _position = 0 there, so 0 is a LOW reading. Reporting HIGH
    made SplitFlapController::update()'s move-to-target branch re-trigger
    home-correction every ~61 steps: the rotor never passed ~61 and only target 0
    (space) ever settled. Window is now wrap-side only. Corrected the same buggy
    snippet/prose in the plan, the design doc and INSTALL-sim.md.
    FIX 2 — test_smoke.mjs now asserts moves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
    [attiny_protocol.h, main.cpp, split_flap_display_async.ino]
2026-09-06 feat(sim): flap shows the glyph physically under the rotor
    The flap view was rendering current_char() (the commanded target, set the
    instant a 'D' lands) gated on !moving — so it snapped straight to the final
    character and, after HOME, kept showing the old glyph instead of the space
    at index 0.
    Add module_get_visible_char(): the glyph at the current rotor angle, the
    inverse of display_char()'s target math. The page now renders it every
    frame, so the flap flaps through every intermediate character as the
    motor turns and settles on space after homing — like the hardware. The
    inspector splits 'target' (commanded) from 'showing' (physical).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
    [main.cpp]
2026-09-07 sim: default the clock multiplier to 1x (real-time)
    At any multiplier the flap sweep was hard to follow. Default to real-time
    now — a full-set move takes ~6s, like the hardware — and leave the rate
    field for anyone who wants to fast-forward.
2026-09-07 sim: I2C console follows the module's live address
    After a pairing session the module moves to 0x10, but the console's
    target-address field still pointed at the old address, so CHANGE (C) went
    to the wrong place and got no ACK. The field now tracks the live module
    (on creation, on pairing, on a successful address change) the way the
    real Pico rescans the bus, and pairing logs a hint about the next step.
2026-09-07 Add power management (de-energize idle motors, cap concurrent moves) and fix module wiring order
    Energy saving:
    - ATtiny84 modules de-energize their stepper coils once idle (move/homing
    complete) instead of holding current indefinitely, since the 28BYJ-48 has
    no absolute position sensor: the next move re-homes first if coils are off.
    - The D (display char) command takes an optional keep_energized byte so
    frequently-updating modes (clock, temp) can hold position between updates
    without paying for a re-home every refresh; static text still de-energizes
    by default. A manual button step also keeps energized, but times out after
    10s of inactivity since there's no guaranteed follow-up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
    [main.py, split_flap_display_async.ino]
2026-09-07 Integrate energy-saving/wiring firmware changes with the merged simulator
    Rebase pulled in the ATtiny84 simulator + host test PR, which extracted
    PowerManagedStepper/SplitFlapController and the command/status protocol
    into split_flap_controller.h / attiny_protocol.h, leaving the .ino as
    thin Wire/EEPROM/ISR glue. Re-applies this branch's energy-saving work
    on top of that new structure instead of the old monolithic .ino:
    - Coil energize/de-energize state, the D command's keep_energized byte,
    the P (power-down) command, is_busy()/is_energized(), and the
    button-hold idle timeout all now live in split_flap_controller.h.
    - attiny_protocol.h's handle_command() takes the D command's optional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
2026-09-12 Fix print_string reversal bug and harden boot/WiFi behavior
    - print_string crashed with NotImplementedError on strings containing
    non-ASCII characters (e.g. temp mode's "65°F") because MicroPython's
    string implementation doesn't support step!=1 slicing on such strings.
    Reported with a 3-module setup. Reverse via reversed()+join instead,
    which only does forward single-character indexing.
    - The boot-time I2C scan looped forever if no module ever answered,
    freezing the Pico. Cap it at 10s (I2C_SCAN_TIMEOUT_MS) and continue
    booting with no modules rather than hanging.
    - Add an onboard-LED status indicator (update_led()): solid on when
    WiFi is connected and at least one I2C module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
    [main.py]
2026-09-12 fix(pico): reduce continuous coil-holding heat for MODE_TIME/MODE_TEMP
    Holding two stepper coils energized indefinitely (full-step drive, no PWM
    current-limiting) generates sustained heat, and MODE_TIME previously held
    every digit energized for as long as the mode was active -- effectively
    forever on a clock display. Reported hot to the touch on hardware.
    - print_string()'s keep_energized param now also accepts a list/tuple (one
    bool per character) alongside the existing plain-bool form.
    - time_keep_energized() only holds the minutes-units module -- the one
    digit that changes on every single update. Hours and minutes-tens change
    far less often, so they're left False and just de-energi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
    [main.py]
2026-09-13 Auto-detect display width, add multi-row layout, skip unchanged chars
    Removes the hardcoded 4-character assumption throughout: module count
    is auto-detected from the I2C bus and used for the text input length,
    Claude's prompt/response sizing, and print_string()'s padding. Adds a
    char_per_row config (default -1 = single row) so text wraps onto
    additional physical rows of modules.
    Also stops print_string() from resending a D command to modules whose
    target character hasn't changed -- previously this forced a pointless
    re-home every time on any de-energized module, since the ATtiny always
    re-homes on a D command when coils are off, even to the same position.
    Fixes ModulesPage's mobile layout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
    [main.py]
2026-09-13 Submit Text/Ask Claude on Enter key, in addition to the button
    Claude-Session: https://claude.ai/code/session_018whDHgXP2SRs4uYXnEVWW9
2026-09-13 Home unpaired ATtiny84 modules at boot, show pairing status char
    A fresh (unpaired) module previously stayed completely idle until the
    button was long-pressed. Now it homes at boot like any paired module
    (visible confirmation it's alive) and displays '?' to show it isn't
    paired yet. Entering pairing mode now similarly re-homes and displays
    'P' to show it's ready to be assigned a real address by the Pico.
    Also extends the ATtiny84 wasm simulator to mirror this boot/pairing
    behavior, adds a "start unpaired" option to its UI (mutually exclusive
    with "remember address"), and fixes a console log line that overflowed
    the panel.
    Claude-Sessi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
    [main.cpp, split_flap_display_async.ino]
2026-09-15 Add over-the-air firmware update endpoint
    POST /api/firmware/update streams a raw zip upload straight to flash,
    unpacks it (a minimal local-file-header zip reader supporting stored
    and deflate entries, since MicroPython has no zipfile module), and
    reboots. The upload never goes through the existing UTF-8-decoding
    request reader, which would corrupt binary bytes; only files listed
    in FIRMWARE_FILES are ever written, guarding against path traversal
    or overwriting config files. Wired up in api.js and a new "Firmware
    Update" card on SetupPage.
    deploy.sh gains a --ota <host> option that zips the same six firmware
    files and POSTs them to this endpoint via curl, as an alternative to
    the existing U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
    [main.py]
2026-09-15 Make the Pico reachable at openflaps.local and fix OTA firmware updates
    Sets network.hostname("openflaps") before connecting to WiFi, which is
    all that's needed for openflaps.local to resolve: MicroPython's rp2
    port has had a working built-in mDNS responder since v1.25.0. An
    earlier version of this change shipped a hand-rolled UDP mDNS
    responder, since at the time it wasn't confirmed the built-in one
    actually worked -- it was removed after confirming on real hardware
    that the built-in responder is already active, which made the custom
    one both redundant and actively harmful: it crashed boot outright
    trying to bind the same UDP port the built-in responder already held
    (OSError: [Errno 98] EAD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
    [main.py]
2026-09-16 Replace MODE_TIME/MODE_TEMP with configurable layout templates
    Adds firmware/pico/layout.py, a small template engine ({field:width}
    placeholders with a zero/space-pad convention) driving a new MODE_LAYOUT
    that replaces the previously hardcoded time/temperature display modes.
    Layouts are named, user-edited (name, template) pairs persisted in
    layout_config.json and managed from a new SetupPage "Layouts" card;
    ControlPage gets a sizing-aware dropdown (via GET/POST /api/layouts) to
    pick which one is live. The energy-saving minutes-digit hold/rest
    behavior generalizes to work regardless of a template's field order or
    padding.
    Design: docs/plans/2026-09-16-layout-templates-design.md
    Plan: docs/pl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
    [layout.py, main.py]
2026-09-18 Add MCP server for the OpenFlaps display, layout templates, and safe concurrent Pico access
    Adds an MCP server (mcp-server/) exposing the OpenFlaps split-flap display
    to Claude Desktop, phone, and Code: OAuth-gated tools for setting text,
    switching layouts, asking Claude for a display-sized quip, running the
    8-ball, homing, and managing modules/timezone/config, backed by a thin
    PicoClient HTTP wrapper around the Pico's existing API. Designed to run on
    an always-on home server (e.g. a Raspberry Pi) behind a Cloudflare Tunnel;
    see mcp-server/DEPLOY.md.
    Integrates the Pico's layout-templates API (replacing the old fixed
    set_mode/MODE_TIME/MODE_TEMP modes with user-defined {field:width}
    templat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
    [main.py]
2026-09-18 mcp-server: widen PicoClient's default timeout from 10s to 20s
    Every mutation-triggering call (set_text, set_layout, eight_ball, home,
    module calibration) goes through the Pico's mutation_lock, and a request
    that finds it held simply queues for however long the in-flight display
    dispatch takes -- by design, not an error condition. A single dispatch
    has been measured up to ~9s on an 8-module display earlier in this
    session, so a contended request plus its own dispatch could plausibly
    exceed the old 10s default with no real problem on the Pico's end.
    Observed live: set_layout("Date") failed with "Pico unreachable ...
    timed out" and succeeded on retry ~7s later -- the same queueing
    behavior th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
2026-09-18 mcp-server: widen PicoClient's default timeout further, 20s to 30s
    20s only budgeted for waiting out a queued predecessor's dispatch. But
    set_text/home/eight_ball/set_layout don't just wait for mutation_lock --
    once acquired, their OWN dispatch can also run ~9-14s (home_all()
    re-homes every module regardless of whether it changed, so if anything
    it's the longest single op). Queue behind someone else's dispatch and
    then run your own and worst case approaches 25-28s, leaving 20s little
    margin. 30s covers one queued predecessor's dispatch plus the call's own
    worst-case dispatch. ask_claude's own 60s override is unaffected and
    still has comfortable headroom above its ~40-45s realistic worst case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
2026-09-19 Remove the 8-ball game
    Drops the /api/8ball route and eightball_roll() from the Pico firmware,
    the 8-BALL button and api.eightBall() from the frontend, and the
    eight_ball tool from the MCP server. Rebuilt firmware/pico assets.
2026-09-19 Add weather layout fields: condition, humidity, wind speed/direction
    get_weather() replaces get_outdoor_temp() and fetches temperature,
    humidity, WMO weather code and wind speed/direction in one open-meteo
    current= request. New layout fields: condition, humidity, wind_mph,
    wind_kmh, wind_deg, wind_dir. uses_temperature() becomes uses_weather().
    [layout.py, main.py]
2026-09-19 layout: table-drive weather fields, drop unused weather param from time fields
    Time/date field functions take only the localtime tuple. Weather fields
    declare the reading they use ("key") and a "convert" function; render()
    handles the missing-reading case once, and uses_weather() derives from
    each field's "source" instead of a hand-maintained tuple. Output is
    identical across a 139-template x 35-input matrix.
    [layout.py]
2026-09-19 Add per-layout alignment (left/center/right)
    Each layout gets an 'align' setting that positions its rendered text within
    each physical row when shorter than the row. Applied in
    render_active_layout() under mutation_lock with the live module count via
    layout.align_rows(); last_text holds the aligned text so the UI preview
    matches. SetupPage gets an alignment dropdown per layout; POST /api/layouts
    validates and GET returns it; older layouts without the key stay left.
    [layout.py, main.py]
2026-09-19 Let the Pico control homing: no ATtiny boot-homing, throttle I, re-dispatch new modules
    Every module homed at once at power-up (and home_all() sent I to all of
    them back to back), bypassing max_concurrent_modules.
    ATtiny: setup() no longer calls initialize(); it ends with power_down(), so
    a booted module is idle and de-energized and its first D re-homes it. That
    first D comes from the Pico's throttled print_string(). An unpaired module
    shows '?' on a short press (apply_short_press()) instead of at boot; long
    press still pairs and shows P.
    Pico: extract dispatch_throttled() from print_string() and use it for
    home_all() too. update_led()'s bus recheck flags newly seen modules and
    tick() re-d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
    [attiny_protocol.h, main.cpp, main.py, split_flap_display_async.ino, test_main.cpp]
2026-09-26 Make the weather location configurable instead of hardcoded
    Replace the LAT/LON constants in main.py with a gitignored
    location_config.json on the Pico, loaded at boot like the timezone.
    Add GET /api/location and POST /api/setup/location (validated lat in
    [-90, 90], lon in [-180, 180]; config write under mutation_lock), and a
    "Weather Location" card on SetupPage.
    With no saved location, get_weather() falls back to an approximate
    location from the public IP (ip-api.com), looked up once per boot and
    kept in memory only. POST /api/location/detect (SetupPage's DETECT
    button) returns a fresh lookup without saving it, for the user to
    review and save. Both fetches share a new http_get_json() helpe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
    [main.py]
2026-09-27 Add reminders; default ATtiny speed 16
    Reminders: alarm-style scheduled messages (e.g. "DR APPT 10AM") that take
    over the split-flap display at a set time, then restore whatever it was
    showing before. Set from the web UI or from Claude via MCP.
    - Schedules: once, daily, weekly (chosen weekdays), monthly (day of month,
    skipping months without it), yearly (Feb 29 only in leap years); all
    times device-local. Optional duration (minutes; none = until dismissed,
    next occurrence, or expiry) and optional expiry. Max 20. Finished and
    expired reminders are deleted automatically.
    - Dismiss from the ControlPage banner, API or MCP; setting text, switching
    layout or a successful Claude request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
    [main.py, reminders.py, split_flap_display_async.ino, test_reminders.py]
2026-09-27 MCP deploy: name the service, system user and tunnel openflaps
    Rename the systemd unit to openflaps-mcp.service (User=openflaps) and use
    openflaps for the service, system account, Cloudflare tunnel and example
    Claude Code connector name in DEPLOY.md, matching the /opt/openflaps paths.
    Code identifiers (OAuth scopes, cookie names, package name) are unchanged so
    existing sign-ins keep working.
2026-10-04 Load char_per_row before AP provisioning displays its status
    start_ap_provisioning() shows "AP" via print_string(), which reads the
    char_per_row and max_concurrent_modules globals, but both were only
    assigned after connect_wifi() -- which never returns in AP mode. Load
    them before connect_wifi(), and take mutation_lock around the AP-status
    dispatch like every other I2C operation.
2026-10-05 Add BME280 indoor sensor (temperature, humidity, pressure) as layout fields
    Driver: firmware/pico/bme280.py, dependency-free. It probes 0x76 then
    0x77, accepts only chip ID 0x60 (rejects a BMP280, which has no
    humidity), takes forced-mode x1 reads, and uses Bosch's integer
    compensation formulas.
    Pico (main.py):
    - The sensor is on I2C1 (GP2 SDA / GP3 SCL, physical pins 4/5), a
    separate bus from the flap modules on I2C0, so reads don't take
    mutation_lock.
    - It's detected once at boot; a missing sensor or unexpected error is
    non-fatal.
    - It's read every 60 s, only when the active layout uses a sensor field.
    - Failed or out-of-range reads keep the last good values.
    - GET /api/state and /a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
    [bme280.py, layout.py, main.py, test_bme280.py, test_layout_fields.py, test_layout_sensor.py]
2026-10-05 Require full width for measurement fields; widen old layouts on load
    A numeric field narrower than its value keeps only its rightmost digits:
    right for {year:2}, but a measurement shows a wrong number (-15 C as
    '-5', 100 % as '00', 1013 hPa as '013').
    - Minimum width now equals the maximum for temperature_f/_c, humidity,
    wind_mph/_kmh, wind_deg (3) and pressure_hpa (4). Indoor temperature and
    humidity keep 2: indoors never reaches 100 or goes below -9.
    - layout.widen_template() raises too-narrow widths to the new minimum
    (keeping zero-padding); load_layouts() applies it at boot and saves the
    result once, so layouts saved under the old limits keep loading instead
    of being skipped.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
    [layout.py, main.py, test_layout_fields.py, test_layout_sensor.py, test_layout_widths.py]
2026-10-06 Cap homing steps and report a home-not-found module status
    A jammed drum or broken limit switch made a module step forever with its
    coils energized and report busy forever, so the Pico's
    dispatch_throttled() held mutation_lock indefinitely and froze the display.
    ATtiny: each homing phase is capped at ~1.5 drum revolutions. Hitting the
    cap stops homing, de-energizes, drops any pending move and sets a sticky
    "home not found" state until a later homing succeeds. Byte 3 of the status
    response becomes a code: 0 ready, 1 busy, 2 home not found.
    Pico: only status 1 counts as busy, so any fault frees its dispatch slot.
    GET /api/modules adds a "status" field. Faulted modules are tracked in
    memory (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
    [attiny_protocol.h, main.py, split_flap_controller.h, split_flap_display_async.ino, test_main.cpp]
2026-10-27 Scale flap preview for 4-16 chars; clock-aligned weather/sensor refresh; precompiled Pico app
    Flap preview (SplitFlapDisplay):
    - Tiles size from the grid's width (container query units) and the row's
    tile count, capped at the old 72x96 look, so 16 characters no longer
    overflow squeezed tiles.
    - Characters are centered across the whole tile with the seam drawn over
    them, like a real split-flap, about 1.8x bigger than before.
    Weather / indoor sensor refresh (new refresh.py):
    - One configurable interval for both: 1/5/10/15/30/60 min, default 15
    (refresh_config.json, GET /api/refresh_interval,
    POST /api/setup/refresh_interval, SetupPage card).
    - Clock-aligned slots (15 min -> :00, :15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
    [app.py, main.py, refresh.py, test_refresh.py]
2026-11-01 Apply DST rule hours in local time, not UTC
    tz.py treated each DST rule's hour as a UTC hour, so US zones left DST
    hours early (Eastern switched at 22:00 EDT on Oct 31 instead of 02:00 on
    Nov 1) and started it hours late. Rule hours are now local wall-clock
    time in the offset in effect before the change, and transitions use
    reminders.py's calendar maths instead of time.mktime(). Sydney and
    Adelaide now end DST at 03:00 as they should. Adds host tests.
2026-11-01 Add an illustrated, generated assembly guide, the PCB files, and sync mechanical parts
    tools/generate_assembly_guide.py renders mechanical/ASSEMBLY-GUIDE.md, its
    figures (mechanical/images/) and the parts block of PRINT-GUIDE.md from the
    STLs and the three Onshape assembly exports (Character Assembly, Daisy Chain,
    Pico Case), so the guide can be regenerated whenever the parts or the CAD
    change. The 3MF exports stay outside the repo; --no-images and --check work
    without them, from the fastener snapshot in tools/assembly_guide/fasteners.json.
    - Software renderer (small C z-buffer compiled at run time, numpy fallback):
    exploded views with numbered callouts, one figure per step.
    - Fastener si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
    [BOM_PCB_Controller.csv, BOM_PCB_Controller.xlsx, BOM_PCB_Daisy_Chain.csv, BOM_PCB_Daisy_Chain.xlsx, BOM_PCB_Pico_Controller.csv, BOM_PCB_Pico_Controller.xlsx, PickAndPlace_PCB_Controller.csv, PickAndPlace_PCB_Controller.xlsx]
2026-11-01 Assembly guide: third Pico Case Lid screw and nut
    The updated Pico Case and Lid fasten with three M3x20 screws and M3 nuts (top,
    bottom and front). Updates both STLs, step 14 and the hardware table, and
    regenerates Part 3. Step 14 now says the lid nuts go in slots in the case's
    outer walls, which is what the model shows, rather than in posts. A header on
    the small board at the back of the case is now drawn with the Pico PCB instead
    of being dropped as an unknown body.
    [Split Flap Character - Pico Case Lid.stl, Split Flap Character - Pico Case.stl]
2026-11-01 Assembly guide: hardware table says the lid nuts go in slots
    Matches step 14.
2026-11-01 Assembly guide: hide the small board at the back of the Pico case
    The guide doesn't cover it yet, so its three bodies (tagged ~Gjse in the CAD
    export) are left out of the figures. Remove the tag from IGNORED_BOARD_TAGS to
    bring it back.
2026-11-07 Assembly guide: photos of a real Pico case build in Part 3
    Step 14 now follows the real build: Pico PCB into the case, case onto the
    first character, power and I2C cables to the Backboard (a new sub-step, not
    in the CAD), then the lid. Each sub-step shows its photos, and the Complete
    section shows the finished display.
2026-11-07 Assembly guide: Pico-to-Backboard cable connectors; tell case and lid screws apart by position
    Step 14 and the per-display hardware table now give the cables' connectors:
    JST XH for the 5V power cable, 2.54 mm pitch for the I2C cable.
    The Pico Case's corner screws are really M3x20, the same as the lid's, so the
    two groups can't be told apart by length once the model is fixed; they're now
    grouped by how far out from the Frame they sit. Grouping of the current export
    is unchanged.
2026-11-07 Assembly guide: Pico Case corner screws are M3x20
    Regenerated Part 3 from the corrected Pico Case model.
2026-11-07 Assembly guide: list M3x20 motor screws
    The real build and the Daisy Chain model use M3x20 for the motor; the
    Character Assembly and Pico Case models still have M3x12, which also fits. A
    fastener group can now name the part the guide lists ("use"), so the motor
    screws read M3x20 whatever the CAD has, and every M3 case or motor screw is
    the same length. The hardware table notes that an M3x12 fits too.
2026-11-07 Assembly guide: regenerate figures from the updated Character Assembly and Pico Case
    Part 1 now shows the Frame's cable bar and the M3x20 motor screws; Parts 2
    and 3 are re-rendered from the current exports. No text changes.
2026-11-07 Add arduino-cli upload script for the ATtiny84 firmware
    firmware/attiny84/upload.sh compiles and flashes the module firmware over
    ISP with the same board options as the Arduino IDE (build is identical),
    so modules can be flashed from the command line on macOS or Linux,
    including a Raspberry Pi. It can also set fuses, read them back, and
    install the pinned ATTinyCore 1.5.7 (--setup) from the pyavrocd index;
    drazzy.com stops at 1.5.2, which is broken with avrdude 7+.
    The install guide's board settings and fuse values are updated to match
    the real configuration (BOD 2.7 V, LTO on, hfuse 0xD5).
2026-11-07 README: photo of the finished display, current features, hardware and setup path
    Replaces the photo placeholder with the finished display; brings Features up
    to date (layouts, reminders, BME280, OTA, MCP server); lists hardware per
    character, per block of four and per display, matching the PCBs and the
    assembly guide; and walks through print, PCBs, assembly, firmware and pairing.
    Repository structure gains hardware/, mechanical/ and mcp-server/.
2026-11-07 Specify the power supply: 5 V, 5.5 x 2.5 mm barrel plug, 3 A or more
    In the README and the guide's per-display hardware table.
2026-11-07 Assembly guide: drop the M3x12 note from the motor screws
    The parts list now only names M3x20 for the motor.
2026-11-07 Follow the CAD for every screw again; link the live simulator in the README
    The Pico Case model now has M3x20 motor screws too, so the per-group size
    override ("use") is no longer needed and is removed; Part 3 is re-rendered from
    the updated model. The README's Features list links the jsDelivr-hosted ATtiny84
    simulator, published to the gh-actions branch by CI; it resolves once the repo
    is public.
2026-11-07 Flash the ATtiny84 before the Controller PCB goes into its character
    Step 9 now starts with flashing the firmware through the ICSP header, before
    the PCB is installed; it's removed from the guide's closing "Then" section,
    along with the tip about adjusting the limit switch before flashing. The
    README's getting-started list and the PCB README say the same.
2026-11-07 Assembly guide: the Frame's diagonal slot is the switch cable route
    Step 7 guessed it was a screw slot for adjusting the motor; it's where the
    limit switch cable runs along the back of the Frame (step 6), which now calls
    it the diagonal slot.
2026-11-07 Assembly guide: the attachment clip fits either way round
    The clip's STL is symmetric end-to-end and side-to-side, so the "confirm which
    way round" warning is replaced by: hooked ends into the groove.
2026-11-07 Assembly guide: drop the status note's line about warnings
    No warnings are left in the guide.
2026-11-07 Assembly guide: longer displays; clarify the first character's corner nuts
    Part 2 gains "More than four characters": blocks join like characters, I2C
    runs through the Backboards plugged into each other, and each block gets its
    own JST XH power cable from the Pico PCB, so power isn't lost along a long
    chain. The step 10 note now says the first character's corner nuts go in as
    usual and take the Pico case's screws, rather than "stay empty".
2026-11-07 Assembly guide: pair the characters right to left
    Starting next to the Pico case, since the firmware writes text from the lowest
    address at the right. Part 2's note points there instead of to CLAUDE.md.
2026-11-07 License the 3D models under CC BY-SA 4.0
    mechanical/stl/ (the printed parts and the flaps) is now CC BY-SA 4.0, with a
    LICENSE.md there; the code and PCB files stay MIT. The README's License
    section and the print guide say which applies where.
2026-11-07 PCB README: order from any fab, not via EasyEDA (#36)
    The Gerber zips work with any PCB fab; the link to EasyEDA's in-app ordering
    guide suggested the design software was needed. Notes the LCSC part numbers
    suit JLCPCB assembly, and the manufacturer part numbers work elsewhere.
2026-11-12 Release script: build the hardware kit and publish a GitHub release (#38)
    * Release script: build the hardware kit and publish a GitHub release
    tools/release.sh <version> [--dry-run] builds release/<version>/openflaps-<version>.zip
    (STLs, flap 3MFs, the assembly and print guides as PDFs, PCB files, licenses, catalog
    photos, a start-here README) plus a catalog folder of loose files for Thingiverse and
    Printables, then (after confirmation) tags, pushes and creates the GitHub release.
    - Logic in tools/release/kit.py, host-tested in tools/release/test_kit.py.
    - PDFs via markdown-pdf in a pinned venv (PyMuPDF 1.28.2: prebuilt Intel-Mac wheel);
    relative links rewritten to GitHub at the tag, he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
2026-11-12 Remove the unused older gear STLs (#39)
    Gear - Stepper.stl and Gear - Wheel.stl were the older gear pair; the build
    uses the 50x30 set. They still ended up in the release kit and catalog
    folder, where they looked like parts to print. Drop them, the guide's note
    about them and the generator's NOT_IN_GUIDE exception.
    [Gear - Stepper.stl, Gear - Wheel.stl]
